brancz/urchin-plus-plus/reports/phase6/jlc-placement/dock-diodes.png

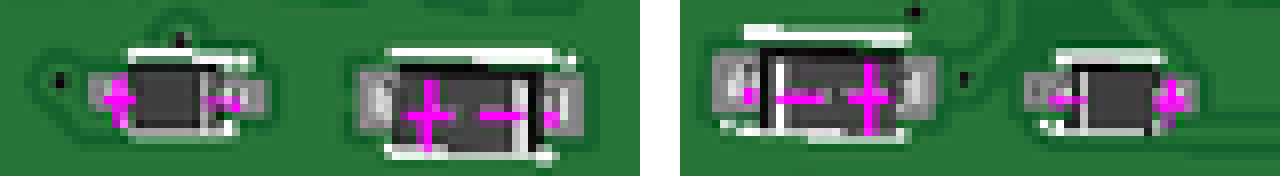
reports/phase6/jlc-placement/dock-diodes.png
