brancz/urchin-plus-plus/reports/phase3/render-left-top.png

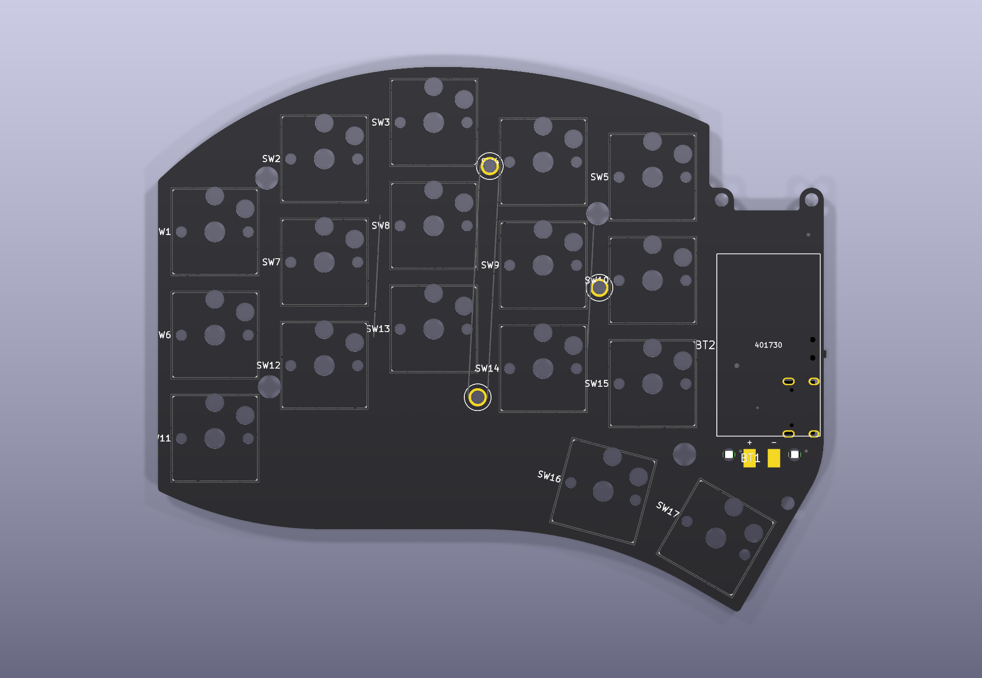
reports/phase3/render-left-top.png
