brancz/urchin-plus-plus/hardware/README.md

# hardware

atopile project for the keyboard halves (phase 2 onward): `ato.yaml`, `.ato` sources, `parts/` (generated by `scripts/parts/import_lcsc.py`), and the KiCad layouts for the left and right half under `layouts/`. Build with `scripts/ato_build.sh hardware`, never bare `ato build`.
