brancz/urchin-plus-plus/dock-pcb/README.md

# dock-pcb

atopile project for the dock board (phase 7), built by the same pipeline as `hardware/`: `scripts/ato_build.sh dock-pcb`.
