brancz/urchin-plus-plus/reports/phase0/README.md

# Phase 0 — toolchain proof

Dates: 2026-10-17 to 2026-10-18. Machine: macOS (arm64), bash 3.2. CI: GitHub Actions in the `kicad/kicad:9.0.9` image (Linux, bash 5), plus a macOS syntax job.

## Exit criteria

| Criterion (docs/PLAN.md) | Result | Evidence |
|---|---|---|
| Clean round-trip report | **KiCad 10.0.7: fails.** atopile can't rebuild a board KiCad 10 has saved. **KiCad 9.0.9** (the documented fallback): all 12 steps pass, locally and in CI | `kicad10-probe/`, `roundtrip/` |
| CI green on an empty build | green: run 39119942514 | see "CI" |
| Exact tool versions and Freerouting checksum in SETUP.md | recorded; `scripts/checks/toolchain.sh --local` passes, including the frozen dependency trees | `docs/SETUP.md`, `toolchain.env`, `constraints/`, `roundtrip/toolchain.txt` |
| Repo layout, `.gitignore`, CI skeleton | done | repo root, `.github/workflows/ci.yml` |
| Reviewer pass | two rounds; every finding fixed or dispositioned | `review.md` |

## Round-trip (`scripts/roundtrip/run.sh`, also run in CI)

The fixture (`scripts/roundtrip/fixture/`) is a two-resistor divider and a decoupling capacitor (LCSC C25744, C1525), both with bottom-side footprints as rule 2 requires, plus a mechanical M2 hole on the top. It is built in a throwaway git repo, and every build goes through `scripts/ato_build.sh`, the same wrapper the real boards use.

| Step | What it proves | Result |
|---|---|---|
| 1 build | first build through the wrapper | 4 footprints, format 20241229 |
| 2 pcbnew edit | JLC-like design rules, an outline, moves and rotations (one at 15°), B.Cu tracks, a via, a two-layer GND zone, the hole placed; saved by KiCad 9 | DRC 0 errors, 0 unconnected |
| 3 rebuild | every edit survives: `board_diff --strict` (empty semantic diff, identical canonical pcbnew serialization) | pass; DRC identical to step 2 |
| 4 idempotent | a second rebuild and `ato build --frozen` change nothing | pass |
| 5 add a part | exactly one footprint added, nothing else changes | pass, after `fix_stale_nets` put back 3 copper items that atopile left off their nets |
| 6 stable | rebuild and `--frozen` change nothing after the new part is placed | pass |
| 7 uncommitted save | net churn, then a pcbnew save without a commit (KiCad renumbers nets), then a rebuild: a free MID via stays MID | pass |
| 8 rename | net MID → MIDPOINT in the circuit: copper follows, and board_diff reports a rename | pass |
| 9 refused | a footprint atopile didn't create, a footprint flipped against its library side, and a locked footprint are each refused before atopile runs, and the board is left untouched | pass |
| 10 board history | `board_history.sh` over the repo's commits; a commit that drops a track fails unless its message allows it; merge commits are skipped | pass |
| 11 Freerouting | rip up, DSN export, Freerouting 2.5.0, SES import | DRC 0 errors, 0 unconnected |
| 12 KiKit | `kikit fab jlcpcb` | 16 Gerber/drill files |

DRC reports warnings only: `silk_overlap` and `silk_over_copper` from the easyeda2kicad footprints' own silkscreen (F5).

## KiCad 10 probe (`scripts/roundtrip/kicad10_probe.sh`)

atopile builds the fixture, and KiCad 10.0.7's pcbnew edits and saves it (format 20260206). The next `ato build` fails with `UnexpectedType in kicad.pcb.Layer field 'tenting'`, both with atopile 0.15.7 and with 0.15.9, the last CLI release. KiCad 10 writes `(tenting (front yes) (back yes))` into every board's setup, so every KiCad 10-saved board is affected.

## Findings about the toolchain

| # | Finding | Disposition |
|---|---|---|
| F1 | atopile (0.15.7 and 0.15.9) can't read any board saved by KiCad 10. | KiCad 9.0.9 per the fallback, installed side by side at `/Applications/KiCad9`. The guardrail rejects KiCad files newer than KiCad 9's formats, and every KiCad-using script checks the version first. |
| F2 | atopile's part server is gone: NXDOMAIN since about 2026-07-18 (atopile#1829). 0.15.8+ needs a login to a legacy endpoint (HTTP 401 without one), and the CLI is end-of-life (`upstream-checks.txt`). | All parts are local atomic parts from `scripts/parts/import_lcsc.py`, so builds are offline. Stay on 0.15.7, with its dependency tree frozen in `constraints/`. |
| F3 | atopile re-creates a net under a new number when fewer than 80% of its pads already carry its name, and leaves that net's tracks, vias, and zones behind: on macOS on the old, now meaningless number; on Linux on net 0. KiCad recomputes the net of copper that touches a pad on load, but free copper (stitching vias, stubs) and zones (resolved by `net_name`) end up on the wrong net or none. | `scripts/fix_stale_nets.py` matches each copper item by UUID to the pre-build snapshot. It keeps net numbers atopile kept (including in-place renames) and restores the rest by name. Steps 5, 7, and 8, on both platforms. |
| F4 | atopile deletes every footprint it didn't create. | Every footprint is an atopile part, mechanical ones too (atomic part, explicit `has_designator`, `exclude_from_bom`/`exclude_from_pos_files`). The guardrail refuses footprints that don't resolve to a library. Steps 2 and 9. |
| F5 | easyeda2kicad footprints draw silkscreen over their own pads. | Open item for phase 2: check each footprint against its datasheet land pattern. |
| F6 | atopile re-syncs every footprint from its library on each build and matches items by geometry only, so two items with the same geometry on different layers get merged (here an F.CrtYd circle became B.CrtYd). | The guardrail rejects such footprints. `board_diff --mode build` fails if an existing footprint's graphics, pads, attributes, or field placement change while its library footprint doesn't. |
| F7 | `kicad-cli fp/sym upgrade` writes files in its own KiCad version's format. | The importer refuses a `kicad-cli` that isn't the pinned version, and the guardrail checks every `.kicad_mod`/`.kicad_sym`. |
| F8 | `has_datasheet` makes `ato build` download the URL, and LCSC's is a product page. | The importer doesn't emit it. Datasheets go in `docs/datasheets/`. |
| F9 | Instance net-name traits on `ElectricPower.hv/lv` are ignored. | Open item for phase 2: name rails on plain signals. |
| F10 | KiKit's `fab jlcpcb --assembly` needs a schematic, and atopile produces none. | Open item for phase 6: BOM from atopile, CPL from `kicad-cli pcb export pos`. |
| F11 | atopile flips each footprint to its library's side and back on every build. For a front-side library footprint placed on the bottom, the flip corrupts text rotations on every build (permanent `--frozen` failure). | Bottom-side parts get bottom-side library footprints (`footprint_to_bottom.py`, the importer's default), and the guardrail refuses a footprint on the other side from its library. Steps 2–6 at 15° and 270°, plus the step 9 refusal. |
| F12 | atopile drops whatever its data model lacks: locks on footprints, tracks, and zones; zones inside footprints; `fp_curve`; text boxes; groups; extra zone outlines. | The guardrail mirrors atopile's model (`pcb.zig`) and refuses such content before building. Keep-outs, including the antenna keep-out (rule 6), are board-level rule areas. Step 9 (lock). |

## CI

Green: https://github.com/brancz/urchin-plus-plus/actions/runs/39119942514 (commit 6c2ccd6). In that run:

- toolchain check OK, and all 137 installed atopile/KiKit packages are pinned
- the 12-step round-trip passes on Linux
- the guardrails pass on the committed KiCad files
- board history is OK (no design boards yet)
- the macOS job parses every script with bash 3.2 and compiles them with Python 3.9
- the dock environment installs from its lockfile

Earlier runs failed twice, and both failures led to fixes. In the first, the round-trip failed at step 5 on Linux, which is how F3's platform difference was found. In the second, the guardrail correctly rejected the KiCad 10 evidence board under `reports/`.

The second review round's fixes were checked against the reviewer's repro scripts and are covered by the round-trip. They have not been re-reviewed independently.

## Reproduce

```bash
scripts/checks/toolchain.sh --local
scripts/roundtrip/run.sh scratch/roundtrip reports/phase0/roundtrip
scripts/roundtrip/kicad10_probe.sh /Applications/KiCad/KiCad.app reports/phase0/kicad10-probe
scripts/roundtrip/upstream_checks.sh > reports/phase0/upstream-checks.txt
```
