brancz/urchin-plus-plus/reports/phase7/review.md

# Phase 7 review: findings and dispositions

## Dock review

The reviewer subagent reviewed the dock (the dock PCB and the tray) on 2026-10-24, in the uncommitted working tree after 93ffe1b, from artifacts and datasheets only. It re-ran KiCad 9.0.9's DRC on a copy (0 errors, 0 unconnected, 11 cosmetic warnings), a zone refill (no change) and `mech dock-geometry --check` (current). It did not re-run the full `mech build`.

It confirmed, with no findings:

- J1 (C2927029): pinout A5 CC1, B5 CC2, A9/B9 VBUS, A12/B12 GND, shell GND; the pad order, leg pads and slots, leg spacing, and the front face flush with the board edge.
- Two separate 5.1 kΩ CC pull-downs; LED1 pad 1 is the anode (about 1.2 mA); D1 pad 1 is the cathode, on DOCK_5V; F1 between VBUS and DOCK_5V.
- The pogo pins' 2.3 mm lands and nets (GND / 5V / GND), on the halves' TP1 pads, and the magnet cutouts on MK2.
- The outline, holes and J1 against `geometry.json`; copper widths for 0.2 A and for a fault until the fuse trips; BOM and CPL (7 lines, all top side, stock checked); the tray pieces on the 180 mm bed; screw engagement; magnet walls and depth.

| # | Finding | Disposition |
|---|---|---|
| H1 | The rubber feet's height was unspecified, and the documented heights (3.5 mm; 5 mm with a USB cable) would lift a case off the pins: the tray's foot pockets fitted a foot of at most 2.4 mm. | **Fixed.** The tray's holes under the feet go right through (10 mm for the 6 mm feet), so any foot up to 7.4 mm tall docks (`checks.json` → `hardware`, "case feet"). The hardware list asks for 6 × 2 mm bumpers. ARCHITECTURE now says the old minimums were for the bare board: in the case, the floor covers the bottom parts, and a plugged-in cable's overmold stays about 0.3 mm above the case's underside (corrected in the second review, L-2). |
| M1 | The free pin tips (13.0 mm) stood above the rim (12.0 mm), so the walls couldn't guide a half before it met the pins. | **Fixed.** The pockets are 8.2 mm deep. Their straight walls reach 7.0 mm above the floor, above the tallest free tip in the worst case (6.46 mm) plus the case's 0.4 mm bottom chamfer, so the case is in the straight walls before its underside reaches the tips. A new check enforces it ("the pocket guides a half before the pins meet it"). The pins now stay below the rim with nothing docked. |
| M2 | The pin-landing check left out the dock PCB's float, the screws, the flange on its land, the pin's tilt and the case's rotation. | **Fixed.** `dock_checks.py` now solves how far a case moves and turns in its pocket, and a board in its case (its walls and its three locating screws), from their outlines as a linear program. To that it adds the dock PCB on its bosses (0.25 mm, with JLC's ±0.2 mm on the milled holes), pocket to boss (0.1), the flange on its land (0.15) and tilt (0.1), per axis. The bosses now locate the bar: 0.15 mm clearance round them, while the outline has 0.3 mm. The RSS is 0.86 mm against 1.1 mm of room across the pad; the worst case, 1.69 mm, is reported (it misses the pad's 1.25 mm half-width only if every term lines up). The same stack sizes the case's window: it needs 1.54 mm and has 1.75 mm, after widening its margin from 1.0 to 1.5 mm (the old 1.0 mm failed the new check). |
| M3 | The feet had 0.5 mm radial clearance in Ø7 pockets, less than the case's float plus the foot's play in its seat. | **Fixed.** The holes are 10 mm. The new check moves each foot by the case's solved play plus 0.2 mm in its seat: at most 1.4 mm, against 2.0 mm of room to the hole's wall and to the dock PCB's edge. |
| M4 | The VBUS link from A9 to B9 ran on F.Cu under J1's grounded shell, before the fuse. | **Fixed.** A rule area J1_FRONT (F.Cu, no tracks or vias) covers J1's footprint from 0.2 mm in front of its pad row to its front. `place.py` draws it and checks it, and DRC enforces it. After re-routing, VBUS joins A9 and B9 behind the pads. |
| M5 | Each tray insert had a 0.43 mm wall beside the hollow under the receptacle's legs. | **Fixed.** The screws moved from 7.0 to 8.3 mm either side of the receptacle (the tab widened to 21 mm). A new check measures the printed wall round each insert hole over its depth: 1.72 mm, against a 1.0 mm minimum. |
| L1 | 0.2 mm recess clearance is no more than JLC's ±0.2 mm outline tolerance. | **Fixed/accepted.** The outline has 0.3 mm. The magnet bosses keep 0.15 mm, because they now locate the bar (M2). Their float, holes included, is in the landing stack. If the board doesn't drop over the bosses, sand the bosses (assembly step 2 in `mech/README.md`). |
| L2 | The pin's datasheet is thin; the compression stack left out the case's standoffs (linear minimum 0.19 mm). | **Fixed.** The stack now includes the case's standoffs and the pin's solder joint, per term. By RSS the compression is 0.51 to 1.09 mm, inside 0.2 mm to the 1.4 mm stroke. The worst case, 0.19 to 1.41 mm, is reported. The ±0.15 mm height tolerance is still the 4020-01R sibling's (stated in `params.py`), so the assembly steps now include measuring the pins' height with calipers. |
| L3 | A redundant GND track passed 0.18 mm from P2's 5 V pad; a zero-length DOCK_5V track sat at P5. | **Fixed/accepted.** The zero-length track was a 0.1 µm Freerouting stub onto a pad it saw 0.1 µm off; `route.py` now drops segments shorter than 1 µm. After re-routing, the GND track joining P1 and P3 is 0.24 mm from P2's pad, above the 0.15 mm rule, under solder mask; it stays as Freerouting left it. (The first rationale given here, that GND never depends on the pour, was false; see the second review, L-1.) |
| L4 | The EasyEDA land patterns differ slightly from the datasheets (all solderable; none wrong in polarity or pinout). | **Accepted.** These are JLC's own library footprints for these parts, which it assembles routinely. |
| L5 | A tripped polyfuse (up to 125 °C) sits on PCB resting on PLA; a steel clip across the pins would hold it tripped. | **Mitigated.** The 1.2 mm hollow under the receptacle now reaches 2 mm past the fuse's centre (about 1.2 mm past its body), so the PCB doesn't touch PLA under it. The pins are now below the pockets' rims. The README says what a dark LED means (a short, fuse tripped: unplug and clear the pocket). |
| L6 | The tray joint is weak: one insert per piece, no key, and the PCB's solder joints take the bending. | **Fixed.** Gluing the split is now an assembly step: the PCB aligns the pieces, then thin CA wicks into the 0.2 mm gap. |
| L7 | Halves may be hard to lift out against two magnets each, with no finger notch. | **Fixed.** A notch in each pocket's outer wall (9 mm radius, down to 1 mm above the floor) gives a finger the case's side. Lifting force is still to be felt on a print. |

## Second review

The reviewer subagent reviewed phase 7 again on 2026-10-24, from artifacts and datasheets only: the dispositions above, the cases and battery covers (their first review), and anything the fixes might have broken. It reproduced `scripts/dock/fab.sh` (identical BOM and CPL, DRC 0 errors) and `scripts/mech/build.sh` (identical `checks.json`), re-solved the dock's play LP with only the outline segments that face a wall (same result), and probed unfilled-zone connectivity, standoff walls, thin regions and part heights with its own scripts.

It verified H1, M1–M5, L1, L2, L6 and L7 as described, and found L3's rationale false and L5's wording loose (both corrected above). No finding needs a change to the keyboard PCB.

It confirmed, with no findings: the dock's pinouts and polarities against the datasheets; that even the worst-case landing leaves over 1 mm to the next pad; the screw stacks; the insert, magnet and skin walls; nearest metal to the antenna keep-out (34.4 mm); the covers over the battery and LED windows; the USB-C notch and plug clearances; printability (bed, slicer, negligible thin regions); the dock's rule areas and trunk; Python 3.9 and bash 3.2 parsing; and CI coverage of the dock.

| # | Finding | Disposition |
|---|---|---|
| M-A | No JLC upload checklist for the dock PCB: the owner would upload without knowing what to check, and a reversed D1 (TVS) would short 5 V and trip the fuse. | **Fixed.** `README.md` has a "JLC upload checklist: dock PCB": board options (2 layers, 1.6 mm, HASL fine, single board), top-side assembly, "Confirm parts placement", and where to look in the preview for D1's cathode band, LED1's anode, J1's mouth and legs, and the pins. Also the intended DFM items (cutouts, pin-in-paste legs, clipped silkscreen) and soldering J1's legs after delivery. |
| M-B | The lips over the board's outer edge had 0.1 mm of play: their underside fell mid-layer, and a board 0.16 mm thick (JLC's ±10 %) would not fit. The fit check couldn't see it, because the PCB is a "touching" part. A 0.6 mm lip could hold only 0.0–0.2 mm of the edge with the board's play. | **Fixed.** `LIP_PLAY` 0.2 mm puts the underside on a layer boundary at 7.0 mm, 0.04 mm over a board 0.16 mm thick; `LIP_OVER` is 0.8 mm. New rows in `checks.json` → `hardware` check both lips per half: underside on a layer boundary and clear of a thick board; the tilt a board can go in at (11° nominal, 2° thick, pushed against the wall); and how far each lip stays over the edge with the board's play in its case (solved, 0.4 mm inward) and JLC's ±0.2 mm outline: 0.35 mm by RSS (minimum 0.3), 0.2 mm worst case. |
| L-1 | The L3 rationale and `route.py`'s docstring claimed GND never depends on the pour; on the dock, P4 and P6 have no GND track and the P1–P3 track joins only those two. | **Fixed.** Both texts now say the pour completes GND (on the dock, the right half's GND pins hang on the pour alone), and connectivity is counted with the zones filled, as DRC does (0 unconnected). Electrically fine: each pin's land joins the pour on both layers through thermal spokes, for about 0.1 A. The P1–P3 track stays: 0.24 mm from P2's pad, above the rule, under mask. |
| L-2 | ARCHITECTURE put the plug's axis 4.0 mm above the case's underside and its overmold 0.75 mm clear; the receptacle hangs 3.26 mm below the PCB, so the axis is about 3.6 mm and the overmold about 0.3 mm clear. | **Fixed** in ARCHITECTURE (and H1 above). The decision holds: the notch runs full height, and the feet lift the case anyway. |
| L-3 | Compression leaves out the half's bow and twist and PLA shrink, and its worst case (0.19 mm) is already at the limit. | **Accepted, with a step.** `mech/README.md` dock step 6: check each half charges in the dock, pressed and released; if not, measure the pin height and the pad depth with calipers. The knob is named: the case's `FLOOR` (one layer less adds 0.2 mm of compression), a case reprint. |
| L-4 | The case standoffs under the two holes at the antenna end have about 0.5 mm of wall where they're cut back for nearby parts. | **Accepted, documented.** They print. The nylon screws there go in finger-tight (`mech/README.md` assembly step 5, step 3 when this was written, says why). |
| L-5 | The standoff's hex size was assumed (3.2 mm across flats) but not specified; common M2 nylon standoffs are up to 4 mm. | **Fixed.** The model is now a 4 mm hex (4.62 mm across corners), and the hardware list says "at most 4 mm across flats". The fit check passes with it (nearest: the SW17/SW33 keycap, 0.32 mm). |
| L-6 | The insertion check doesn't model the lips or the tilt. | **Fixed** by the lip rows (M-B): the tilt a board can go in at is now a checked number, and changing `LIP_*` moves it. |
| L-7 | The power-switch scoop left a 0.4 mm wall beside the slot. | **Fixed.** `SWITCH_SCOOP_DEPTH` 1.2 mm leaves 0.8 mm (two lines). |
| L-8 | Nits: a params comment said M2 × 4; `fab.sh` named the wrong Gerber zip; no action given for a pin out of range; magnet pockets and foot holes look alike from below; the cover can rock by the board's thickness tolerance; the fit row didn't name the lips' exemption; L5's wording. | **Fixed:** the comment, the zip name, the pin step (reflow, or note it and see step 6), which holes take magnets (dock step 1), the fit row, L5. **Accepted:** the cover rocking by up to 0.16 mm is cosmetic. |

## Hardware change

After the phase closed, the hardware was changed to parts sold in Germany (`docs/ARCHITECTURE.md`, "Hardware bought in Germany"): posts printed on the battery cover and nylon nuts instead of bought standoffs, M5 washers instead of steel discs, and a fit model of the largest 401730 cell sold. The reviewer subagent reviewed the change on 2026-10-24 in the uncommitted working tree after 1d533fc, from artifacts and datasheets only. It re-ran `scripts/mech/build.sh` without renders (identical `checks.json`, 0 failed) and probed the cell, keycaps, LED holes, posts, screw heads, magnet force and footprints with its own scripts.

No high-severity findings, 2 medium, 8 low. None needs a change to the keyboard PCB.

It confirmed, with no findings: the screw stack (head 0.2 mm inside the underside, tip 1.8 mm above the nut, 1.45 mm at the screw's shortest), the head's bearing on the standoff, the heads against the dock parts, the posts printing roof down without overhangs, rule 6 (only nylon and PLA at the holes in the keep-out; the washers 47.3 mm away), the washer in its recess, the 6.4 mm magnet pocket, the roof over the cell (0.5 mm), the cell against the keycaps beside it (1.16 mm), the assembly order, and the fit rows lost and gained against the previous commit.

| # | Finding | Disposition |
|---|---|---|
| M1 | The cover's posts (4.6 mm round) and the nuts sat 0.33 mm from four keycaps (left SW5 and SW17, right SW18 and SW33) over the keycaps' whole height, and only the screws locate the cover: about 0.4 mm of play on a 2.4 mm bore. The checks tested only the nominal position, and `KEYCAP_MARGIN`'s comment and ARCHITECTURE's "clear the keycaps the same way" were false. | **Fixed.** Posts 4.0 mm across on a 2.3 mm bore (0.85 mm of wall, two lines; the bore prints about 2.2 mm and locates the cover on the screws). New fit rows grow each post by the cover's play (0.36 mm: the screw off the PCB hole's centre plus the bore off the screw, at an M2's smallest diameter): 0.261 mm from SW5, SW17, SW18 and SW33 (nominal 0.625). The nuts next to a keycap are turned with a flat toward it (`mech/README.md` step 6), and the nut model is that hexagon grown by its screw's play (0.16 mm): 0.467 mm. `KEYCAP_MARGIN`'s comment and ARCHITECTURE corrected. |
| M2 | The longer cell runs onto the wire pads (BT1) and partly over both LED light holes; the model placed it from the courtyard, not the outline the docs name; no check sees board parts against the cell. | **Fixed, placement kept.** The cell stays on the outline's antenna-side end: moving it toward the antenna would use up the 3 mm keep-out margin. `board_data.py` now extracts BT2's outline and BT1's pads; the model starts at the outline (3.75 mm from the keep-out), and a new hardware row reports the keep-out gap (at least 3 mm), the reach over the pads (0.4 mm), the room above the solder joints on the 1 mm foam (0.2 mm for a 28 AWG wire laid flat) and how much of each LED hole it covers (21 %, at most half allowed). `mech/README.md` ("The cell") now says to cut the foam to the outline, solder the wires first, then lay the cell. |
| L1 | The cover-screw stack no longer applied `MIN_THREAD` (the nut gives 1.6 mm). | **Fixed.** `MIN_THREAD` is now stated as the rule for screws in printed parts and inserts; a nut must have its whole height engaged (DIN 934 sizes it for the screw), and the row checks that with a board 0.16 mm thick (tip 1.64 mm above the nut). |
| L2 | The nut and the untrimmed screw end stand above the neighbouring keycaps; the README said to trim "if you like"; a nut driver doesn't fit beside the keycaps. | **Fixed.** `mech/README.md` step 7: trim all three flush with the nut. Step 5: hold the nut with tweezers, or pull the two nearest keycaps. The nut's top stays 1.2 mm above the keycap model's top, where the old M2 × 3 heads were 0.4 mm above it: accepted. |
| L3 | The washer's recess adds 0.1–0.3 mm to the magnet gap, so the hold is weaker than "70 % of a disc" (estimate: 10–12 N per half against at most about 3.5 N from the pins less the half's 1 N); dock step 6 didn't test the hold. | **Fixed.** Dock step 6 checks by hand that a half sits flat, doesn't rock and takes a definite pull to lift, and names the remedies: 10 × 5 mm magnets, then a thinner skin under them. ARCHITECTURE gives the estimate instead of the 70 % figure. |
| L4 | The skirt and the posts both rested at the PCB's top height, so with a thin board the posts don't clamp the PCB. | **Fixed.** The skirt ends one layer (0.2 mm) above the wall's top (`SKIRT_LIFT`), on a layer boundary: the posts set the cover's height. |
| L5 | Stale or inconsistent docs: standoffs in ARCHITECTURE, the cell's size in three versions, the cell from the courtyard vs the outline, "steel disc" in several places, the phase 6 checklist's two nylon screws. | **Fixed** in ARCHITECTURE, `params.py`, `mech/README.md` and `reports/phase6/README.md`: the cell is "up to 32 × 17.5 mm and 4.5 mm thick" everywhere, modelled from the outline; three nylon screws and nuts per half. |
| L6 | `docs/SETUP.md`: female-female jumpers can't connect to TP2's surface-mount pads. | **Fixed.** SETUP and `firmware/README.md`: solder a 5-pin 2.54 mm header or five wires to TP2 for the first flash and remove it before casing, or use a 2.54 mm pogo clip. |
| L7 | The README's status cites a CI run older than these rows; no review entry for the change. | **Fixed.** This section, and the README's status separates the phase's CI run from this change's. |
| L8 | No lead-in on the post's bore for a screw fed blind from below; a DIN 985 lock nut (steel body) is a likely mis-buy in the keep-out. | **Fixed.** A 0.3 mm chamfer at the bore's bottom; the hardware list says all-polyamide DIN 934, not DIN 985. |

## Top shell and dock redesign

The reviewer subagent reviewed the top shell (commit 6435626) and the dock redesign (uncommitted, on top of it) on 2026-10-25, from artifacts and datasheets only: the board files, the STEP export, the Gerbers and CPL, the datasheets of C2848622, C5221284, C123790, C2297 and the Choc v1 switch, and its own computations. It didn't rely on the reports' claims.

One high-severity finding, 5 medium, 7 low. **None needs a change to the keyboard PCB that is already ordered:** the pins solder onto the existing TP1 pads (2.5 × 4.0 mm, for the 2.0 mm flange; the GND pads have thermal reliefs, so they can be hand-soldered). The fixes touch the dock PCB, which is not ordered, and printed parts.

It checked, with no findings: the dock's netlist and polarity (J1's VBUS, GND, CC1 and CC2 each through its own 5.1 kΩ; F1 from VBUS to DOCK_5V; D1's cathode on DOCK_5V; LED1's anode toward R3; the contacts GND / 5 V / GND in TP1's order), the BOM against `dock-bom.md`, the CPL against the Gerbers, DRC and connectivity, ENIG in the board file, and the slots in the PTH drill file.

The CI run of commit 6435626 (40194850673) failed in `scripts/mech/build.sh` on Linux: OCCT could not chamfer the shell's outer walls (`ValueError: Failed creating a chamfer`, `case.py` `shell()`), though it builds on macOS. The case chamfers the same outline by the same 0.6 mm, built at z = 0, and that passes on Linux. **Fixed:** the shell's walls and lid are now chamfered at z = 0 and then moved up, as the case is. This commit's CI run is the proof on Linux; the phase's README records it.

| # | Finding | Disposition |
|---|---|---|
| H1 | The soldering jig covered the pads: none of each TP1 pad beyond the flange was in view from above. The 3 mm strip over the pin row and the bars to the legs and feet lay over the pads' ends, 4.6 mm above the board, so README step 4 ("touch the iron to each pad … at its ends") could only be done sideways past D2, D3 and the barrels, with the PLA plate in the way. `jig_checks` didn't model the iron's access. | **Fixed.** The plate is now a 0.8 mm collar round each bore joined by a 1.8 mm strip along the row, inside the 2.0 mm flanges; the arms to the legs and feet start from the strip's ends, 4.5 mm past the end pins. New rows (`hardware`, per pad and end, both halves): 1.24 mm² of each pad's end (3.43 mm² past the flange) is in view past the plate grown by 0.25 mm, where at least 1.0 mm² is required; before, none was. `mech/README.md` step 4: come in at an angle, keep each touch to 2 to 3 s, keep the iron off the jig. |
| M1 | The bores had 0.1 mm of clearance on the 0.9 mm plunger, a printed hole comes out about 0.1 mm small, and the tips came out through the plate's first layer, with its elephant's foot. | **Fixed.** Bores 1.25 mm (0.35 mm over the plunger). The plate is 2.0 mm thick, so the tips end inside it: 0.55 mm short of the face printed on the bed, 0.3 mm with the longest pin (new terms in the row "jig plate on the plungers"). README step 3: open a tight bore with a 1.2 mm drill by hand. The pin's position error in the jig grows from 0.2 to 0.3 mm in the landing and window stacks: landing 0.91 mm by RSS across a contact (1.45 mm of room) and 0.90 mm along it (2.85 mm); the window needs 1.1 to 1.2 mm and has 1.98 mm. |
| M2 | J1's 3D model sat 0.28 mm off its footprint: its legs 0.28 mm from the slots' centres, into the board. The real part, its legs in the slots, would stand 0.28 mm out of the tray's back face, and its housing would overlap the PCB at the notch's end. The mouth check passed only because it measured the misplaced model, and no row tested J1 against the board. | **Fixed.** Confirmed from HRO's drawing and the model: the mouth is 2.80 mm ahead of the front legs (the 6.8 mm body less 4.00 mm from the front legs to its back). The model's offset in `dock-pcb/parts.json` is now -1.88 mm, which puts its legs on the slots; the footprint's origin moves to 5.28 mm from the back face (`DOCK_USB_FRONT`), so the real mouth is on the face (row "USB-C mouth on the tray's back face"). New fit row: J1's model against the dock PCB, no overlap (it rests on the board's top; its housing is 0.10 mm from the notch's end). J1, R1 and R2 moved 0.28 mm in, and the board was re-placed and re-routed (below). |
| M3 | The notch had sharp inner corners and about 0.08 mm at its end; HRO's layout ends the notch 0.5 mm behind the rear legs, and JLC's router leaves a radius in an inside corner. | **Fixed.** The notch ends 0.5 mm behind the rear legs, as HRO's layout has it (1.62 mm behind the footprint's origin, 0.10 mm behind the housing), and has a 1.0 mm round relief behind each inner corner, so JLC's 1.0 mm router reaches the corners. Reliefs to the side would cut into the legs' pads. The model shows that the part below the board at the notch's end is the plastic housing, 8.34 mm wide, so its corners are 0.43 mm from the notch's sides anyway. With the deeper notch, the signal pads are trimmed 0.14 mm instead of 0.12 (1.26 mm long), for 0.3 mm copper-to-edge. |
| M4 | No minimum foot height was given (README: "about 2 mm"), and the desk check used 2.0 mm feet, uncompressed: 0.35 mm to spare at worst, and a soft desk mat or a squashed bumper puts the pins on the desk. | **Fixed.** The hardware list asks for feet 2.5 to 3 mm tall ("at least 2.5 mm"). The desk row now uses the shortest allowed foot, less its seat and 0.2 mm of squash (`FOOT_SQUASH`): the feet hold the case 1.9 mm up, the tips reach at most 1.25 mm below it: 0.65 mm to spare at worst (0.35 mm before, on nominal 2 mm feet). |
| M5 | The pins have no lateral support: a sideways knock on a 0.85 mm tip acts on a 6 mm lever at a hand-soldered joint on the ordered board's TP1 pads. Proposed: per-pin bores in the floor, about 0.4 mm over the plunger. | **Not adopted.** The pin moves with the board, so a bore must take the board's play in its case and the pin's own error: 1.0 to 1.1 mm a side (the window rows). The barrel's end is inside the 1.6 mm floor, so bores round the barrels would be about 3.8 mm at the 4 mm pitch, and a 0.4 mm bore would bend the pins as the board goes in. The tips are recessed: they stand 0.85 mm below the case's underside, inside the window, and the feet stand 1.9 mm or more, so nothing on a desk reaches them sideways. A pin that bends is resoldered, and TP1's pads are 2.5 × 4.0 mm. |
| L1 | J1's land pattern differs from HRO's: pad front edges further back, a shorter overlap with the tails, slots 0.8 mm wide instead of 0.5. | **Accepted.** The board is power only, and the four through-hole legs (pin-in-paste, and hand-soldered per the checklist) carry the cable's load. |
| L2 | The compression check passes on RSS only; at the RSS minimum, 0.55 mm, the pin is under the 1.0 mm working height at which the datasheet gives its force. | **Accepted.** `mech/README.md` dock step 6 tells the builder how to check and adjust (`FLOOR`). |
| L3 | The worst-case landing goes past the contact's edge; it can't short (the tip would need 1.95 mm to reach the next pad). | **Accepted.** With the jig's 0.3 mm (M1), the worst case is 1.89 mm across, still short of 1.95 mm: an open contact at worst, never 5 V to GND. |
| L4 | Only the tab is held down (under the cover); a bar bowed up by JLC's 0.75 % adds to the compression. | **Fixed.** Dock step 2: a small drop of CA under each bar's outer end, pressed flat for a minute. |
| L5 | Keycaps near the battery lid: 0.36 mm nominal, 0.26 mm with the shell's play. | **Accepted.** The plate locates the shell on the switches (14.0 mm cutouts on the 13.8 mm housings), so the play figure is pessimistic. |
| L6 | The board's stackup says a black solder mask, the checklist said green. | **Fixed.** The checklist says black, as the board does: the board shows in the pocket floors, and black disappears in a black tray. Any colour works. |
| L7 | Not modelled: the M5 washer's hole reduces the magnets' pull (dock step 6 checks it by hand); the plate's 0.55 mm overhang over the clip relief droops a little; black carbon-pigmented PLA over the antenna detunes it slightly (allowed by rule 6). | **Noted.** |

The reviewer also flagged the checks' blind spots, each covered above: the mouth check (M2), iron access and bore shrinkage (H1, M1), the desk with nominal feet (M4), compression and landing on RSS (L2, L3), and the router's corner radius (M3).

The dock PCB after these fixes: J1 0.28 mm further in, with the deeper notch and its reliefs; R1 and R2 moved with it, to keep their place below J1's CC pads. J1's two VBUS tracks join below R1 and R2 at the fuse, on the top layer, which boxed their GND pads in: the router left one connected by a single thermal spoke, and after the move not at all. A scripted pre-route now joins their GND pads through a via between them to the bottom pour (`scripts/routing/preroutes.py`). Re-routed with `route.py --attempts 4`: every variant complete, no starved thermals; 28 tracks, 94 vias, DRC 0 errors, 0 unconnected, 13 warnings (silkscreen at the edge and on pads, as before; J1's outline now also meets the reliefs).

## Floor plates

The reviewer subagent reviewed the floor plates, the 1.2 mm case floor and the 3 mm feet (uncommitted, on top of commit 06f3b06) on 2026-10-25, from artifacts and datasheets only: the diff, the docs, `checks.json`, `slice.json`, the renders, the datasheets of C5221284 and C48783831, its own rebuild of the checks (byte-identical to `checks.json`) and its own measurements of the STEP files.

No high-severity finding, 1 medium, 8 low. **None touches the keyboard PCB or the dock PCB.**

It checked, with no findings: the pins' dimensions and stroke against both datasheets; the height stack (5.15 mm pins, 0.85 mm compression, free tips 1.25 mm below the case, feet 2.4 mm with 0.75 mm to spare, guidance); the docked pin model; the plate's play solved from its outer outline; the slot (12.0 × 6.8 mm, the contacts' corners inside its rounded corners); the 11 mm foot holes; the plates' fit; the washer pads clear of every bottom part; 0.8 mm of standoff round each screw head's counterbore below the floor; the magnet gap (0.9 to 1.15 mm); and every number in the docs against `checks.json` and `slice.json`, with the exceptions below.

| # | Finding | Disposition |
|---|---|---|
| M1 | Dock step 7 named the plate's thickness (`DOCK_FLOOR_T`) as the quickest compression knob, "reprint only the plates". But the tray's top follows it, so the rebuild changes the tray and the cover too, and fails the guidance check, while the parts actually built (the old tray with a thinner plate) are never modelled. A one-layer plate is also fragile. Step 7 also no longer named a remedy for a weak magnet hold. | **Fixed.** The plate is no longer offered as a knob: the case's floor (`FLOOR`) stays the knob for compression, a case reprint, as before. Step 7 now says what a weak hold needs: a CAD change, a hole in each plate over each magnet (0.4 mm closer). |
| L1 | Over the pilot hole beside the thumb keys (H5), the shell's deck went from 1.0 to 0.6 mm, with no check; and the screw's length tolerance (ISO 4759-1 grade A, about ±0.29 mm at 8 mm) wasn't in the tip-gap check: 0.15 mm with a long screw and a thin board, under `MIN_TIP_GAP`. | **Fixed (checked), accepted (values).** New rows check the shell over each pilot's end against `PILOT_MIN_ROOF`, 0.6 mm (three layers, the cover's own minimum skin): 0.6 mm at H5, 3.2 mm under the lid. The screw row now reports the tip gap with a long screw on a thin board (0.15 mm) and fails if it reaches zero. M2 × 8 stays: an M2 × 6 would leave 1.24 mm of thread, under the 2.0 mm minimum, and the head can't go lower. The tip never reaches the pilot's end, so the roof takes no load from it. |
| L2 | Stale numbers in the phase README: the cover is 1.12 mm over J1, not 0.72, and the opening round J1's mouth no longer cuts into the back face's chamfer; a code comment still said it did; "the tip 0.44 mm above the pilot's end" means short of it. | **Fixed**, all three, and the comment in `dock_checks.py`. |
| L3 | The phase README's status line cited this section before it existed. | **Fixed** by this section. |
| L4 | "It drops in only one way" was false: the plates are mirror images within 0.25 mm, so one turned over fits the other pocket, ironed face down. | **Fixed.** Dock step 5 says to lay each plate smooth (ironed) face up, and why. |
| L5 | Spot-gluing a thin ironed plate "near the walls" is ambiguous along the inner wall, where the PCB runs; CA blooms white on black PLA; glue under the plate isn't in the height stack. | **Fixed (instructions), accepted (stack).** Step 5 names where: on the bare tray floor about 3 mm in from the outer, front and back walls, never on the PCB (along the inner wall and under the contacts), never near the slot or holes; gel CA, as little as holds, the pocket open to air while it sets. Glue can only lift a plate, which lowers compression; step 7 checks compression on the built dock. |
| L6 | The compression worst case (1.56 mm) was reported past the 1.4 mm stroke without saying so; the dock PCB's thickness and the recess's depth can only take the contacts deeper (where the PCB stands proud, the plate and the case rest on it), so the real high side is 1.30 mm. | **Fixed.** Those two terms now count only toward the least compression (`DOCK_DEPTH_TOL`). The row reports 0.54 to 1.09 mm by RSS, worst case 0.14 to 1.30 mm, and now fails if the high worst case passes the stroke. Guidance uses the same high side: the tips meet the contacts at 1.30 mm at worst, under the 1.6 mm of straight wall. |
| L7 | Weak spots in the checks: the case's floor openings were cut only through the floor, while the washer pads reach 1.6 mm (each pad 0.3 mm from the dock window); the plate's thin-strip check would pass a short 0.5 mm neck; the slot check had no worst-case flag; the plate's play ignored the cover's own play where the cover forms a pocket wall. | **Fixed.** The floor openings now go through the pads' height. The thin-strip check now allows 0.05 mm² of loss, not 0.5. Each pin row reports whether the worst case stays in the slot (across, about 1.9 mm against 1.55 mm: only if every term lines up, as on the contact). The cover is cut back by its own clearance at the plate's height round each pocket, so a plate keeps its 0.15 mm wherever the cover sits. Above the plate, the cover's wall can still stand 0.15 mm into a pocket, where a plate just goes in under it. |
| L8 | The feet row said shorter feet than 3 mm let the pins touch the desk; 2.5 mm feet still clear it by 0.25 mm at worst, and the owner may already have them. | **Fixed.** The hardware list asks for 3 mm and says 2.5 mm feet still clear the desk by 0.25 mm at worst. |

After the fixes: 161 fit, 11 bed, 86 hardware, 4 insertion and 15 pin checks, 0 failed.
