brancz/urchin-plus-plus/reports/phase4/drc-left.md

# DRC: hardware/layouts/left/left.kicad_pcb (left)

Errors: 0. Unconnected items: 0.

Excused errors (hardware/drc_allow.json):

- 5 x inherited from the original: the tenting puck's bottom courtyard overlaps key socket courtyards (rule 1 geometry; ARCHITECTURE.md 2026-10-18)
- 2 x inherited from the original: hotswap socket pads of SW5/SW17 (left) and SW22/SW27/SW32 (right) overhang the outline by up to 0.4 mm (rule 1; the router trims them)

Warnings by type:

- connection_width: 1
- missing_courtyard: 7
- silk_edge_clearance: 5
- silk_over_copper: 72
- silk_overlap: 50
- starved_thermal: 1
