brancz/urchin-plus-plus/reports/phase6/drc.md

# DRC: /Users/brancz/src/github.com/brancz/urchin++-p4/fab/panel/panel.kicad_pcb (panel)

Errors: 0. Unconnected items: 0.

Excused errors (hardware/drc_allow.json):

- 9 x inherited from the original: the tenting puck's bottom courtyard overlaps key socket courtyards (rule 1 geometry; ARCHITECTURE.md 2026-10-18)
- 5 x inherited from the original: hotswap socket pads of SW5/SW17 (left) and SW22/SW27/SW32 (right) overhang the outline by up to 0.4 mm (rule 1; the router trims them)

Warnings by type:

- connection_width: 14
- missing_courtyard: 97
- silk_edge_clearance: 10
- silk_over_copper: 143
- silk_overlap: 117
- starved_thermal: 1
