brancz/urchin-plus-plus/reports/phase3/drc-left.md

# DRC: hardware/layouts/left/left.kicad_pcb (left)

Errors: 0. Unconnected items: 123 (not routed yet; not counted).

Excused errors (hardware/drc_allow.json):

- 5 x inherited from the original: the tenting puck's bottom courtyard overlaps key socket courtyards (rule 1 geometry; ARCHITECTURE.md 2026-10-18)
- 2 x inherited from the original: hotswap socket pads overhang the outline by up to 0.4 mm (rule 1; the router trims them)

Warnings by type:

- missing_courtyard: 7
- nonmirrored_text_on_back_layer: 37
- silk_edge_clearance: 5
- silk_over_copper: 83
- silk_overlap: 116
