brancz/urchin-plus-plus/reports/phase2/pinmap.md

# Pin map

Generated by `scripts/circuit/gen_halves.py` (`hardware/pinmap.json`). Keys are named rRcC (row 0 = top, column 0 = pinky) and t0/t1 (thumbs, t0 nearer the main keys). GPIO pad: the socket pad wired to the GPIO; the other socket pad is ground. Path: shortest route length from the module pad around the module, the cost the assignment minimizes.

## Left half

| Signal | Switch | GPIO | E73 pin | GPIO pad | Path (mm) |
|---|---|---|---|---|---|
| r0c0 | SW1 | P0.20 | 32 | 2 | 78.7 |
| r0c1 | SW2 | P0.24 | 35 | 2 | 61.6 |
| r0c2 | SW3 | P1.02 | 38 | 2 | 49.5 |
| r0c3 | SW4 | P1.04 | 40 | 2 | 30.4 |
| r0c4 | SW5 | P1.06 | 42 | 2 | 17.3 |
| r1c0 | SW6 | P0.07 | 22 | 2 | 82.8 |
| r1c1 | SW7 | P0.17 | 30 | 2 | 60.4 |
| r1c2 | SW8 | P0.22 | 34 | 2 | 43.4 |
| r1c3 | SW9 | P0.13 | 33 | 2 | 22.4 |
| r1c4 | SW10 | P1.00 | 36 | 2 | 6.0 |
| r2c0 | SW11 | P1.09 | 17 | 2 | 85.2 |
| r2c1 | SW12 | P0.12 | 20 | 2 | 66.2 |
| r2c2 | SW13 | P0.15 | 28 | 2 | 41.9 |
| r2c3 | SW14 | P0.04 | 18 | 2 | 31.5 |
| r2c4 | SW15 | P0.08 | 16 | 2 | 16.0 |
| t0 | SW16 | P0.05 | 15 | 2 | 33.3 |
| t1 | SW17 | P0.31 | 9 | 1 | 38.0 |
| chg_sense | (near D4) | P0.06 | 14 | - | 19.7 |
| led_b | (near R10) | P0.30 | 10 | - | 25.4 |
| led_g | (near R9) | P0.00 | 11 | - | 22.6 |
| led_r | (near R8) | P0.01 | 13 | - | 22.7 |
| pgood_sense | (near D5) | P0.26 | 12 | - | 22.2 |

## Right half

| Signal | Switch | GPIO | E73 pin | GPIO pad | Path (mm) |
|---|---|---|---|---|---|
| r0c0 | SW22 | P0.31 | 9 | 1 | 82.5 |
| r0c1 | SW21 | P1.13 | 6 | 1 | 67.6 |
| r0c2 | SW20 | P0.03 | 3 | 1 | 52.4 |
| r0c3 | SW19 | P1.10 | 2 | 1 | 33.2 |
| r0c4 | SW18 | P1.11 | 1 | 1 | 18.4 |
| r1c0 | SW27 | P0.00 | 11 | 1 | 83.9 |
| r1c1 | SW26 | P0.30 | 10 | 1 | 68.5 |
| r1c2 | SW25 | P0.02 | 7 | 1 | 47.3 |
| r1c3 | SW24 | P0.29 | 8 | 1 | 28.6 |
| r1c4 | SW23 | P0.28 | 4 | 1 | 9.1 |
| r2c0 | SW32 | P0.05 | 15 | 1 | 87.3 |
| r2c1 | SW31 | P0.01 | 13 | 1 | 67.1 |
| r2c2 | SW30 | P0.26 | 12 | 1 | 50.9 |
| r2c3 | SW29 | P0.06 | 14 | 1 | 33.8 |
| r2c4 | SW28 | P0.08 | 16 | 1 | 17.5 |
| t0 | SW34 | P1.09 | 17 | 1 | 31.8 |
| t1 | SW33 | P0.04 | 18 | 2 | 33.7 |
| chg_sense | (near D4) | P0.12 | 20 | - | 19.1 |
| led_b | (near R10) | P0.24 | 35 | - | 33.2 |
| led_g | (near R9) | P0.15 | 28 | - | 31.8 |
| led_r | (near R8) | P0.07 | 22 | - | 24.5 |
| pgood_sense | (near D5) | P0.13 | 33 | - | 30.8 |
