brancz/urchin-plus-plus/reports/phase7/dock/drc.md

# DRC: dock-pcb/layouts/dock/dock.kicad_pcb (dock)

Errors: 0. Unconnected items: 0.

Excused errors (hardware/drc_allow.json):

Warnings by type:

- silk_edge_clearance: 8
- silk_over_copper: 5
