brancz/urchin-plus-plus/reports/phase2/footprints/footprints.md

# Footprints

Every assembled part's footprint as used on the boards (`hardware/parts/`), shown as the front-side land pattern (component side, top view) for comparison with each datasheet's recommended land pattern. Coordinates in mm relative to the footprint origin; rotation in degrees. The boards use the bottom-side versions (x mirrored). SVGs show the copper of each footprint.

## C356849 — WIRELM-SMD_E73-2G4M08S1C

nRF52840 module (Ebyte E73-2G4M08S1C).
Datasheet: [C356849_E73-2G4M08S1C.pdf](../../docs/datasheets/C356849_E73-2G4M08S1C.pdf).

| Pad | Type | Shape | x | y | Rot | Width | Height | Drill |
|---|---|---|---|---|---|---|---|---|
| 1 | smd | rect | -6.500 | -7.010 | 90 | 0.900 | 2.000 |  |
| 2 | smd | rect | -6.500 | -5.740 | 90 | 0.900 | 2.000 |  |
| 3 | smd | rect | -6.500 | -4.500 | 90 | 0.900 | 2.000 |  |
| 4 | smd | rect | -6.500 | -3.200 | 90 | 0.900 | 2.000 |  |
| 5 | smd | rect | -6.500 | -1.930 | 90 | 0.900 | 2.000 |  |
| 6 | smd | rect | -6.500 | -0.660 | 90 | 0.900 | 2.000 |  |
| 7 | smd | rect | -6.500 | 0.610 | 90 | 0.900 | 2.000 |  |
| 8 | smd | rect | -6.500 | 1.880 | 90 | 0.900 | 2.000 |  |
| 9 | smd | rect | -6.500 | 3.150 | 90 | 0.900 | 2.000 |  |
| 10 | smd | rect | -6.500 | 4.420 | 90 | 0.900 | 2.000 |  |
| 11 | smd | rect | -4.450 | 7.010 | 0 | 0.900 | 2.000 |  |
| 12 | smd | rect | -3.810 | 4.910 | 0 | 0.900 | 0.900 |  |
| 13 | smd | rect | -3.180 | 7.010 | 0 | 0.900 | 2.000 |  |
| 14 | smd | rect | -2.540 | 4.910 | 0 | 0.900 | 0.900 |  |
| 15 | smd | rect | -1.910 | 7.010 | 0 | 0.900 | 2.000 |  |
| 16 | smd | rect | -1.270 | 4.910 | 0 | 0.900 | 0.900 |  |
| 17 | smd | rect | -0.640 | 7.010 | 0 | 0.900 | 2.000 |  |
| 18 | smd | rect | -0.000 | 4.910 | 0 | 0.900 | 0.900 |  |
| 19 | smd | rect | 0.630 | 7.010 | 0 | 0.900 | 2.000 |  |
| 20 | smd | rect | 1.270 | 4.910 | 0 | 0.900 | 0.900 |  |
| 21 | smd | rect | 1.900 | 7.010 | 0 | 0.900 | 2.000 |  |
| 22 | smd | rect | 2.540 | 4.910 | 0 | 0.900 | 0.900 |  |
| 23 | smd | rect | 3.170 | 7.010 | 0 | 0.900 | 2.000 |  |
| 24 | smd | rect | 3.810 | 4.910 | 0 | 0.900 | 0.900 |  |
| 25 | smd | rect | 4.440 | 7.010 | 0 | 0.900 | 2.000 |  |
| 26 | smd | rect | 6.500 | 4.420 | 270 | 0.900 | 2.000 |  |
| 27 | smd | rect | 6.500 | 3.150 | 270 | 0.900 | 2.000 |  |
| 28 | smd | rect | 4.410 | 2.510 | 270 | 0.900 | 0.900 |  |
| 29 | smd | rect | 6.500 | 1.880 | 270 | 0.900 | 2.000 |  |
| 30 | smd | rect | 4.410 | 1.240 | 270 | 0.900 | 0.900 |  |
| 31 | smd | rect | 6.500 | 0.610 | 270 | 0.900 | 2.000 |  |
| 32 | smd | rect | 4.410 | -0.030 | 270 | 0.900 | 0.900 |  |
| 33 | smd | rect | 6.500 | -0.660 | 270 | 0.900 | 2.000 |  |
| 34 | smd | rect | 4.410 | -1.300 | 270 | 0.900 | 0.900 |  |
| 35 | smd | rect | 6.500 | -1.930 | 270 | 0.900 | 2.000 |  |
| 36 | smd | rect | 4.410 | -2.570 | 270 | 0.900 | 0.900 |  |
| 37 | smd | rect | 6.500 | -3.200 | 270 | 0.900 | 2.000 |  |
| 38 | smd | rect | 4.410 | -3.840 | 270 | 0.900 | 0.900 |  |
| 39 | smd | rect | 6.500 | -4.470 | 270 | 0.900 | 2.000 |  |
| 40 | smd | rect | 4.410 | -5.110 | 270 | 0.900 | 0.900 |  |
| 41 | smd | rect | 6.500 | -5.740 | 270 | 0.900 | 2.000 |  |
| 42 | smd | rect | 4.400 | -6.380 | 270 | 0.900 | 0.900 |  |
| 43 | smd | rect | 6.500 | -7.010 | 270 | 0.900 | 2.000 |  |

C356849

## C15220 — QFN-16_L3.0-W3.0-P0.50-TL-EP1.7

Li-ion charger with power path (TI BQ24073RGTR).
Datasheet: [C15220_BQ24073RGTR.pdf](../../docs/datasheets/C15220_BQ24073RGTR.pdf).

| Pad | Type | Shape | x | y | Rot | Width | Height | Drill |
|---|---|---|---|---|---|---|---|---|
| 1 | smd | oval | 1.500 | 0.750 | 0 | 0.850 | 0.280 |  |
| 2 | smd | oval | 1.500 | 0.250 | 0 | 0.850 | 0.280 |  |
| 3 | smd | oval | 1.500 | -0.250 | 0 | 0.850 | 0.280 |  |
| 4 | smd | oval | 1.500 | -0.750 | 0 | 0.850 | 0.280 |  |
| 5 | smd | oval | 0.750 | -1.500 | 0 | 0.280 | 0.850 |  |
| 6 | smd | oval | 0.250 | -1.500 | 0 | 0.280 | 0.850 |  |
| 7 | smd | oval | -0.250 | -1.500 | 0 | 0.280 | 0.850 |  |
| 8 | smd | oval | -0.750 | -1.500 | 0 | 0.280 | 0.850 |  |
| 9 | smd | oval | -1.500 | -0.750 | 0 | 0.850 | 0.280 |  |
| 10 | smd | oval | -1.500 | -0.250 | 0 | 0.850 | 0.280 |  |
| 11 | smd | oval | -1.500 | 0.250 | 0 | 0.850 | 0.280 |  |
| 12 | smd | oval | -1.500 | 0.750 | 0 | 0.850 | 0.280 |  |
| 13 | smd | oval | -0.750 | 1.500 | 0 | 0.280 | 0.850 |  |
| 14 | smd | oval | -0.250 | 1.500 | 0 | 0.280 | 0.850 |  |
| 15 | smd | oval | 0.250 | 1.500 | 0 | 0.280 | 0.850 |  |
| 16 | smd | oval | 0.750 | 1.500 | 0 | 0.280 | 0.850 |  |
| 17 | smd | custom | -0.000 | 0.000 | 0 | 0.005 | 0.005 |  |

C15220

## C165948 — USB-C_SMD-TYPE-C-31-M-12_1

USB-C receptacle, USB 2.0 (HRO TYPE-C-31-M-12).
Datasheet: [C165948_TYPE-C-31-M-12.pdf](../../docs/datasheets/C165948_TYPE-C-31-M-12.pdf).

| Pad | Type | Shape | x | y | Rot | Width | Height | Drill |
|---|---|---|---|---|---|---|---|---|
| (hole) | thru_hole | circle | 2.900 | 1.210 | 0 | 0.600 | 0.600 | 0.6 |
| (hole) | thru_hole | circle | -2.900 | 1.210 | 0 | 0.600 | 0.600 | 0.6 |
| 1 | thru_hole | oval | -4.330 | 1.710 | 0 | 1.200 | 2.000 | oval 0.799998 1.499997 |
| 2 | thru_hole | oval | -4.330 | -2.470 | 0 | 1.200 | 1.800 | oval 0.799998 1.199998 |
| 3 | thru_hole | oval | 4.330 | -2.470 | 0 | 1.200 | 1.800 | oval 0.799998 1.199998 |
| 4 | thru_hole | oval | 4.330 | 1.710 | 0 | 1.200 | 2.000 | oval 0.799998 1.499997 |
| A1B12 | smd | custom | 3.200 | 2.470 | 0 | 0.005 | 0.005 |  |
| A4B9 | smd | custom | 2.400 | 2.470 | 0 | 0.005 | 0.005 |  |
| A5 | smd | rect | 1.250 | 2.470 | 0 | 0.300 | 1.300 |  |
| A6 | smd | rect | 0.250 | 2.470 | 0 | 0.300 | 1.300 |  |
| A7 | smd | rect | -0.250 | 2.470 | 0 | 0.300 | 1.300 |  |
| A8 | smd | rect | -1.250 | 2.470 | 0 | 0.300 | 1.300 |  |
| B1A12 | smd | custom | -3.200 | 2.470 | 0 | 0.005 | 0.005 |  |
| B4A9 | smd | custom | -2.400 | 2.470 | 0 | 0.005 | 0.005 |  |
| B5 | smd | rect | -1.750 | 2.470 | 0 | 0.300 | 1.300 |  |
| B6 | smd | rect | -0.750 | 2.470 | 0 | 0.300 | 1.300 |  |
| B7 | smd | rect | 0.750 | 2.470 | 0 | 0.300 | 1.300 |  |
| B8 | smd | rect | 1.750 | 2.470 | 0 | 0.300 | 1.300 |  |

C165948

## C7519 — SOT-23-6_L2.9-W1.6-P0.95-LS2.8-BL

USB D+/D- and VBUS ESD protection (ST USBLC6-2SC6).
Datasheet: [C7519_USBLC6-2SC6.pdf](../../docs/datasheets/C7519_USBLC6-2SC6.pdf).

| Pad | Type | Shape | x | y | Rot | Width | Height | Drill |
|---|---|---|---|---|---|---|---|---|
| 1 | smd | rect | 0.950 | -1.150 | 0 | 0.532 | 1.072 |  |
| 2 | smd | rect | -0.000 | -1.150 | 0 | 0.532 | 1.072 |  |
| 3 | smd | rect | -0.950 | -1.150 | 0 | 0.532 | 1.072 |  |
| 4 | smd | rect | -0.950 | 1.150 | 0 | 0.532 | 1.072 |  |
| 5 | smd | rect | -0.000 | 1.150 | 0 | 0.532 | 1.072 |  |
| 6 | smd | rect | 0.950 | 1.150 | 0 | 0.532 | 1.072 |  |

C7519

## C8598 — SOD-123_L2.7-W1.6-LS3.7-RD-1

Schottky diodes: USB VBUS and dock 5V into the charger input (B5819W).
Datasheet: [C8598_B5819W.pdf](../../docs/datasheets/C8598_B5819W.pdf).

| Pad | Type | Shape | x | y | Rot | Width | Height | Drill |
|---|---|---|---|---|---|---|---|---|
| 1 | smd | rect | 1.700 | 0.000 | 0 | 1.200 | 0.950 |  |
| 2 | smd | rect | -1.700 | 0.000 | 0 | 1.200 | 0.950 |  |

C8598

## C193402 — SOD-123FL_L2.7-W1.8-LS3.8-RD

TVS on the exposed dock 5V pad (SMF5.0A).
Datasheet: [C193402_SMF5.0A.pdf](../../docs/datasheets/C193402_SMF5.0A.pdf).

| Pad | Type | Shape | x | y | Rot | Width | Height | Drill |
|---|---|---|---|---|---|---|---|---|
| 1 | smd | rect | 1.630 | 0.000 | 0 | 1.200 | 1.200 |  |
| 2 | smd | rect | -1.630 | 0.000 | 0 | 1.200 | 1.200 |  |

C193402

## C431540 — SW-TH_MSK12C02

power slide switch between charger OUT and VDDH (MSK12C02).
Datasheet: [C431540_MSK12C02.pdf](../../docs/datasheets/C431540_MSK12C02.pdf).

| Pad | Type | Shape | x | y | Rot | Width | Height | Drill |
|---|---|---|---|---|---|---|---|---|
| (hole) | thru_hole | circle | 1.500 | -0.550 | 0 | 0.900 | 0.900 | 0.9 |
| (hole) | thru_hole | circle | -1.500 | -0.550 | 0 | 0.900 | 0.900 | 0.9 |
| 1 | smd | rect | 2.250 | 1.700 | 90 | 1.524 | 0.600 |  |
| 2 | smd | rect | -0.750 | 1.700 | 90 | 1.524 | 0.600 |  |
| 3 | smd | rect | -2.250 | 1.700 | 90 | 1.524 | 0.600 |  |
| 4 | smd | rect | 3.600 | -1.700 | 0 | 1.200 | 0.700 |  |
| 4 | smd | rect | 3.600 | 0.600 | 0 | 1.200 | 0.700 |  |
| 4 | smd | rect | -3.600 | -1.700 | 0 | 1.200 | 0.700 |  |
| 4 | smd | rect | -3.600 | 0.600 | 0 | 1.200 | 0.700 |  |

C431540

## C720477 — SW-SMD_L3.9-W3.0-P4.45

reset button on P0.18 (TS-1088-AR02016).
Datasheet: [C720477_TS-1088-AR02016.pdf](../../docs/datasheets/C720477_TS-1088-AR02016.pdf).

| Pad | Type | Shape | x | y | Rot | Width | Height | Drill |
|---|---|---|---|---|---|---|---|---|
| 1 | smd | rect | 2.180 | 0.000 | 0 | 1.230 | 1.860 |  |
| 2 | smd | rect | -2.180 | 0.000 | 0 | 1.230 | 1.860 |  |

C720477

## C409782 — LED-ARRAY-SMD_1206-4P-L3.2-W1.3-BR-EH

reverse-mount RGB LEDs, common anode: status (GPIO) and charge (CHG/PGOOD) (MHT151RGBCT).
Datasheet: [C409782_MHT151RGBCT.pdf](../../docs/datasheets/C409782_MHT151RGBCT.pdf).
Corrected from the datasheet: docs/datasheets/C409782_MHT151RGBCT.pdf p.2, 'Recommended Solder Pad (Reverse Type)': 0.8 x 0.7 mm pads, 2.3 mm between pad rows, 2.1 mm hole. EasyEDA's footprint has the pads 0.2 mm closer together and no hole.

| Pad | Type | Shape | x | y | Rot | Width | Height | Drill |
|---|---|---|---|---|---|---|---|---|
| (hole) | np_thru_hole | circle | -0.000 | 0.000 | 0 | 2.100 | 2.100 | 2.1 |
| 1 | smd | rect | -1.550 | -0.550 | 0 | 0.800 | 0.700 |  |
| 2 | smd | rect | -1.550 | 0.550 | 0 | 0.800 | 0.700 |  |
| 3 | smd | rect | 1.550 | 0.550 | 0 | 0.800 | 0.700 |  |
| 4 | smd | rect | 1.550 | -0.550 | 0 | 0.800 | 0.700 |  |

C409782

## C81598 — SOD-123F_L2.7-W1.6-LS3.8-RD

isolate the CHG and PGOOD GPIO reads from the charge LED's input-side supply (1N4148W).
Datasheet: [C81598_1N4148W.pdf](../../docs/datasheets/C81598_1N4148W.pdf).

| Pad | Type | Shape | x | y | Rot | Width | Height | Drill |
|---|---|---|---|---|---|---|---|---|
| 1 | smd | rect | 1.730 | 0.000 | 0 | 1.100 | 1.000 |  |
| 2 | smd | rect | -1.730 | 0.000 | 0 | 1.100 | 1.000 |  |

C81598

## C25744 — R0402

10k: charger TS (no thermistor).
Datasheet: [C25744_R0402_10k.pdf](../../docs/datasheets/C25744_R0402_10k.pdf).

| Pad | Type | Shape | x | y | Rot | Width | Height | Drill |
|---|---|---|---|---|---|---|---|---|
| 1 | smd | rect | 0.430 | 0.000 | 0 | 0.566 | 0.540 |  |
| 2 | smd | rect | -0.430 | 0.000 | 0 | 0.566 | 0.540 |  |

C25744

## C25905 — R0402

5.1k: USB-C CC1, CC2; charger ILIM, ISET.
Datasheet: [C25905_R0402_5k1.pdf](../../docs/datasheets/C25905_R0402_5k1.pdf).

| Pad | Type | Shape | x | y | Rot | Width | Height | Drill |
|---|---|---|---|---|---|---|---|---|
| 1 | smd | rect | 0.430 | 0.000 | 0 | 0.566 | 0.540 |  |
| 2 | smd | rect | -0.430 | 0.000 | 0 | 0.566 | 0.540 |  |

C25905

## C11702 — R0402

1k: charge LED red and green.
Datasheet: [C11702_R0402_1k.pdf](../../docs/datasheets/C11702_R0402_1k.pdf).

| Pad | Type | Shape | x | y | Rot | Width | Height | Drill |
|---|---|---|---|---|---|---|---|---|
| 1 | smd | rect | 0.430 | 0.000 | 0 | 0.566 | 0.540 |  |
| 2 | smd | rect | -0.430 | 0.000 | 0 | 0.566 | 0.540 |  |

C11702

## C25117 — R0402

470R: status LED red, green, blue.
Datasheet: [C25117_R0402_470R.pdf](../../docs/datasheets/C25117_R0402_470R.pdf).

| Pad | Type | Shape | x | y | Rot | Width | Height | Drill |
|---|---|---|---|---|---|---|---|---|
| 1 | smd | rect | 0.430 | 0.000 | 0 | 0.566 | 0.540 |  |
| 2 | smd | rect | -0.430 | 0.000 | 0 | 0.566 | 0.540 |  |

C25117

## C1525 — C0402

100nF 0402: VDD.
Datasheet: [C1525_C0402_100nF.pdf](../../docs/datasheets/C1525_C0402_100nF.pdf).

| Pad | Type | Shape | x | y | Rot | Width | Height | Drill |
|---|---|---|---|---|---|---|---|---|
| 1 | smd | rect | 0.420 | 0.000 | 0 | 0.500 | 0.540 |  |
| 2 | smd | rect | -0.420 | 0.000 | 0 | 0.500 | 0.540 |  |

C1525

## C15849 — C0603

1uF 50V 0603: charger IN (sees up to 26 V on overvoltage).
Datasheet: [C15849_C0603_1uF_50V.pdf](../../docs/datasheets/C15849_C0603_1uF_50V.pdf).

| Pad | Type | Shape | x | y | Rot | Width | Height | Drill |
|---|---|---|---|---|---|---|---|---|
| 1 | smd | rect | 0.700 | 0.000 | 0 | 0.800 | 0.900 |  |
| 2 | smd | rect | -0.700 | 0.000 | 0 | 0.800 | 0.900 |  |

C15849

## C19666 — C0603

4.7uF 16V 0603: charger OUT, charger BAT, nRF VBUS.
Datasheet: [C19666_C0603_4u7_16V.pdf](../../docs/datasheets/C19666_C0603_4u7_16V.pdf).

| Pad | Type | Shape | x | y | Rot | Width | Height | Drill |
|---|---|---|---|---|---|---|---|---|
| 1 | smd | rect | 0.700 | 0.000 | 0 | 0.800 | 0.900 |  |
| 2 | smd | rect | -0.700 | 0.000 | 0 | 0.800 | 0.900 |  |

C19666

## C19702 — C0603

10uF 10V 0603: VDDH bulk.
Datasheet: [C19702_C0603_10uF_10V.pdf](../../docs/datasheets/C19702_C0603_10uF_10V.pdf).

| Pad | Type | Shape | x | y | Rot | Width | Height | Drill |
|---|---|---|---|---|---|---|---|---|
| 1 | smd | rect | 0.700 | 0.000 | 0 | 0.800 | 0.900 |  |
| 2 | smd | rect | -0.700 | 0.000 | 0 | 0.800 | 0.900 |  |

C19702

## BAT_PADS — BAT_PADS

custom pads (scripts/parts/custom_parts.py).
No datasheet (custom pads).

| Pad | Type | Shape | x | y | Rot | Width | Height | Drill |
|---|---|---|---|---|---|---|---|---|
| 1 | smd | rect | -2.000 | 0.000 | 0 | 2.000 | 3.000 |  |
| 2 | smd | rect | 2.000 | 0.000 | 0 | 2.000 | 3.000 |  |

BAT_PADS

## DOCK_PADS — DOCK_PADS

custom pads (scripts/parts/custom_parts.py).
No datasheet (custom pads).

| Pad | Type | Shape | x | y | Rot | Width | Height | Drill |
|---|---|---|---|---|---|---|---|---|
| 1 | smd | rect | 4.000 | 0.000 | 0 | 2.500 | 4.000 |  |
| 2 | smd | rect | -0.000 | 0.000 | 0 | 2.500 | 4.000 |  |
| 3 | smd | rect | -4.000 | 0.000 | 0 | 2.500 | 4.000 |  |

DOCK_PADS

## SWD_PADS — SWD_PADS

custom pads (scripts/parts/custom_parts.py).
No datasheet (custom pads).

| Pad | Type | Shape | x | y | Rot | Width | Height | Drill |
|---|---|---|---|---|---|---|---|---|
| 1 | smd | circle | 5.080 | 0.000 | 0 | 1.500 | 1.500 |  |
| 2 | smd | circle | 2.540 | 0.000 | 0 | 1.500 | 1.500 |  |
| 3 | smd | circle | -0.000 | 0.000 | 0 | 1.500 | 1.500 |  |
| 4 | smd | circle | -2.540 | 0.000 | 0 | 1.500 | 1.500 |  |
| 5 | smd | circle | -5.080 | 0.000 | 0 | 1.500 | 1.500 |  |

SWD_PADS
