brancz/urchin-plus-plus/reports/phase0/roundtrip/versions.txt

date_utc: 2026-10-18T10:34:19Z
kicad-cli: 9.0.9
pcbnew: 9.0.9
kikit: 1.8.1
atopile: 0.15.7
freerouting.jar sha256: f6f51bb02245e8e717f9359bd260cc9c5c0b1bc0acc8b7cb2cd5b8ffeb5de3c7
java: openjdk version "27" 2026-09-15
bash: 3.2.57(1)-release
