brancz/urchin-plus-plus/reports/phase3/placement-left-bottom.png

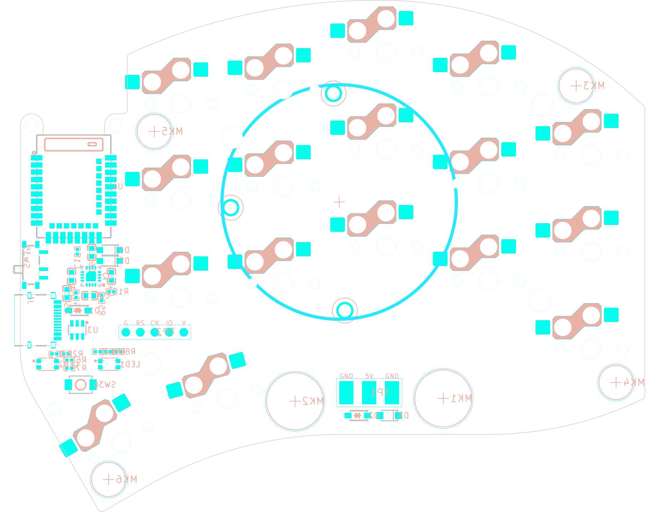
reports/phase3/placement-left-bottom.png
