brancz/urchin-plus-plus/reports/phase3/placement-left-top.png

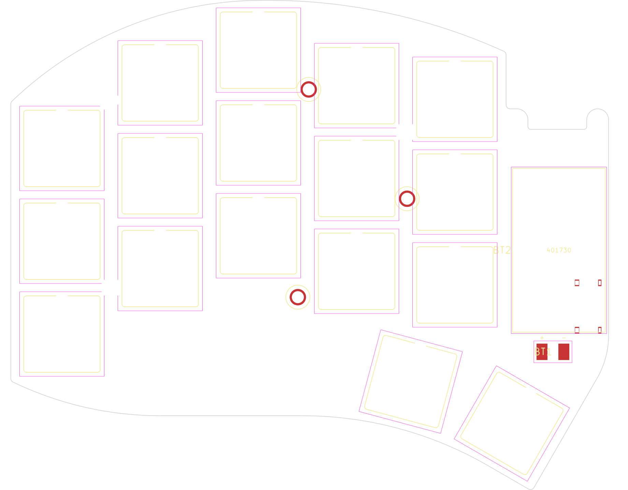
reports/phase3/placement-left-top.png
