brancz/urchin-plus-plus/reports/phase3/placement-right-bottom.png

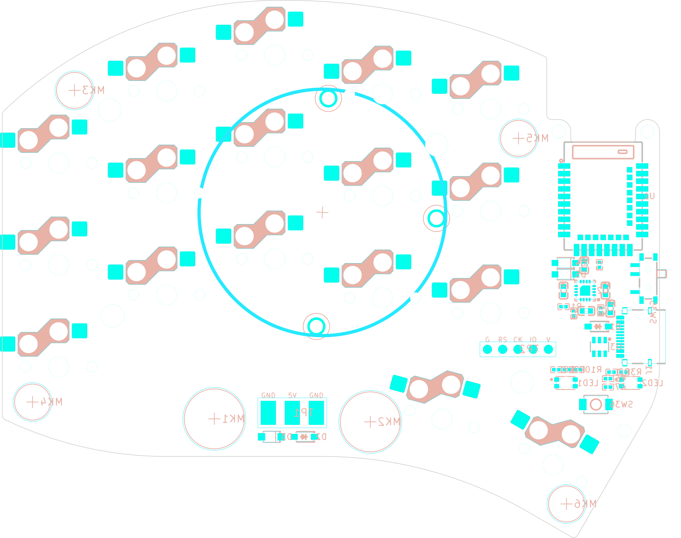
reports/phase3/placement-right-bottom.png
