brancz/urchin-plus-plus/reports/phase3/placement-right-top.png

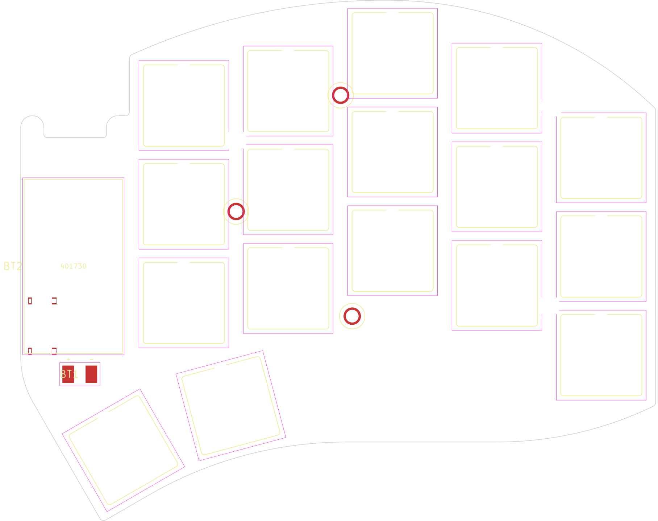
reports/phase3/placement-right-top.png
