brancz/urchin-plus-plus/reports/phase3/render-left-bottom.png

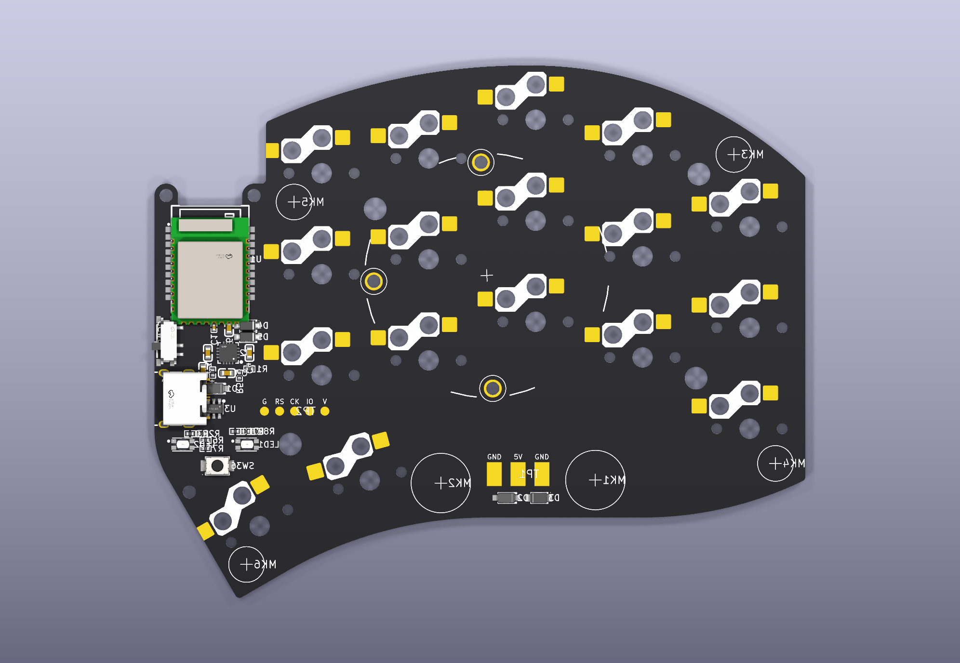
reports/phase3/render-left-bottom.png
