brancz/urchin-plus-plus/reports/phase3/render-right-bottom.png

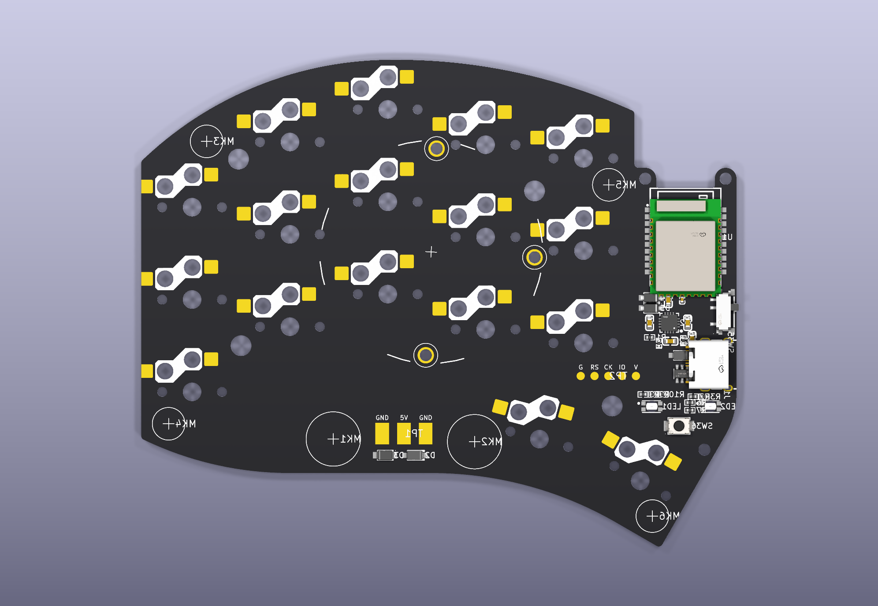
reports/phase3/render-right-bottom.png
