brancz/urchin-plus-plus/reports/phase3/render-right-top.png

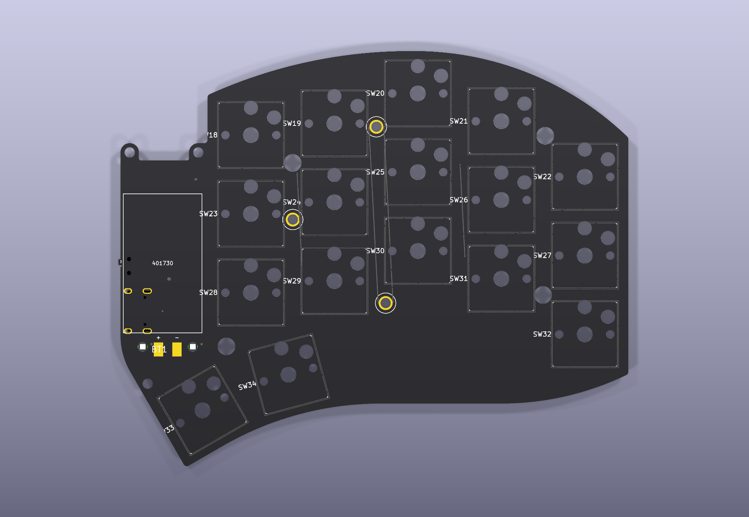
reports/phase3/render-right-top.png
