brancz/urchin-plus-plus/reports/phase4/copper-left-B_Cu.png

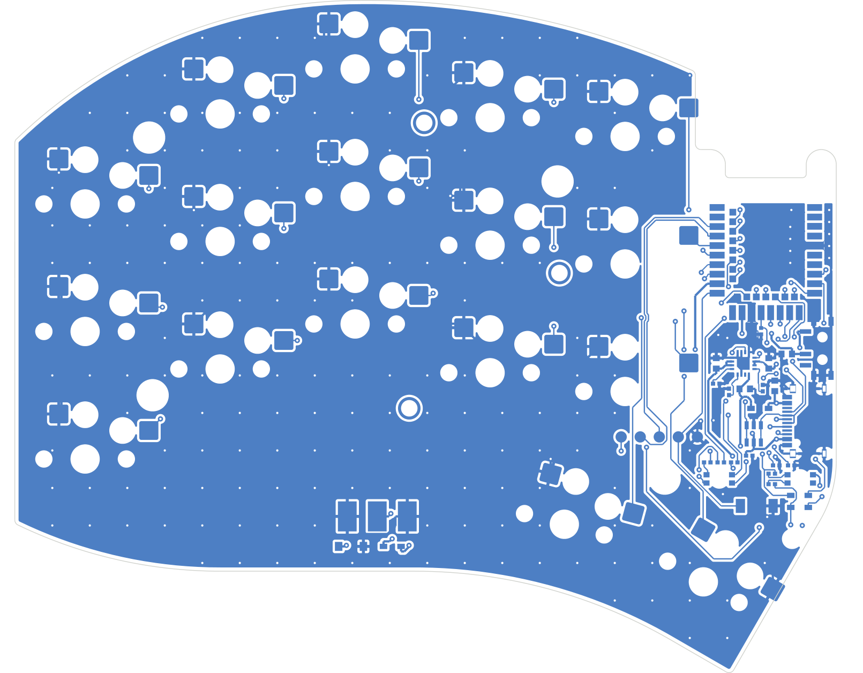
reports/phase4/copper-left-B_Cu.png
