brancz/urchin-plus-plus/reports/phase4/copper-left-both.png

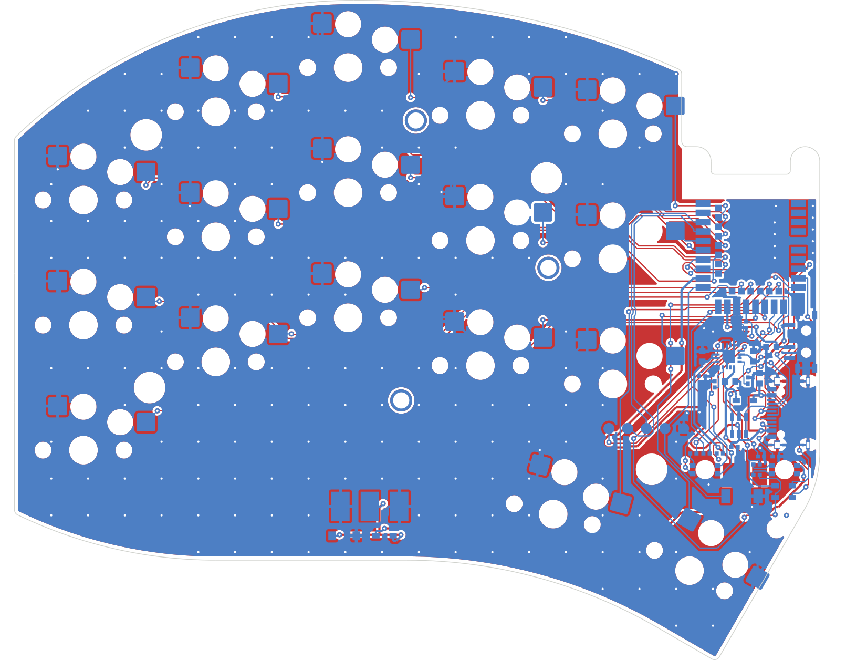
reports/phase4/copper-left-both.png
