brancz/urchin-plus-plus/reports/phase4/copper-right-B_Cu.png

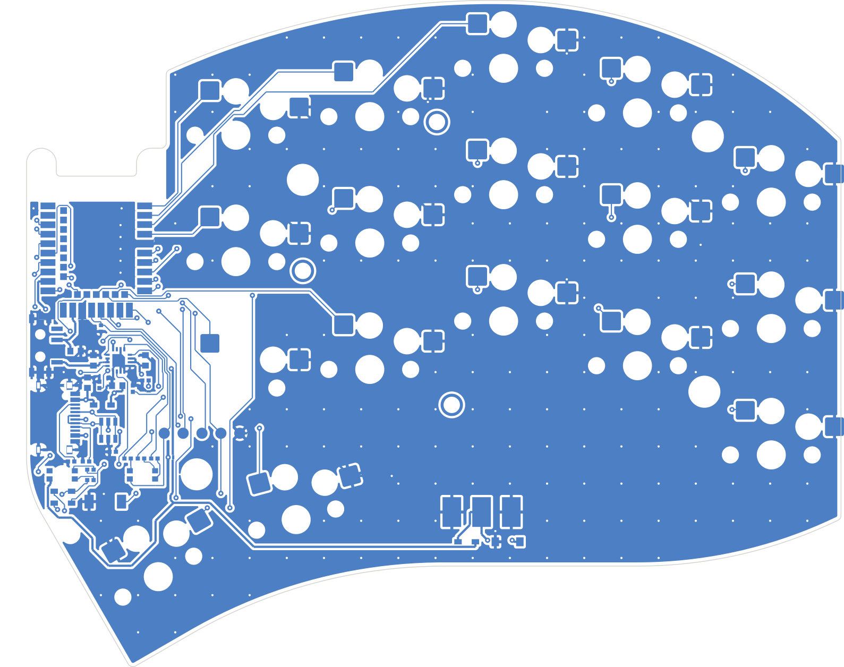
reports/phase4/copper-right-B_Cu.png
