brancz/urchin-plus-plus/reports/phase4/copper-right-both.png

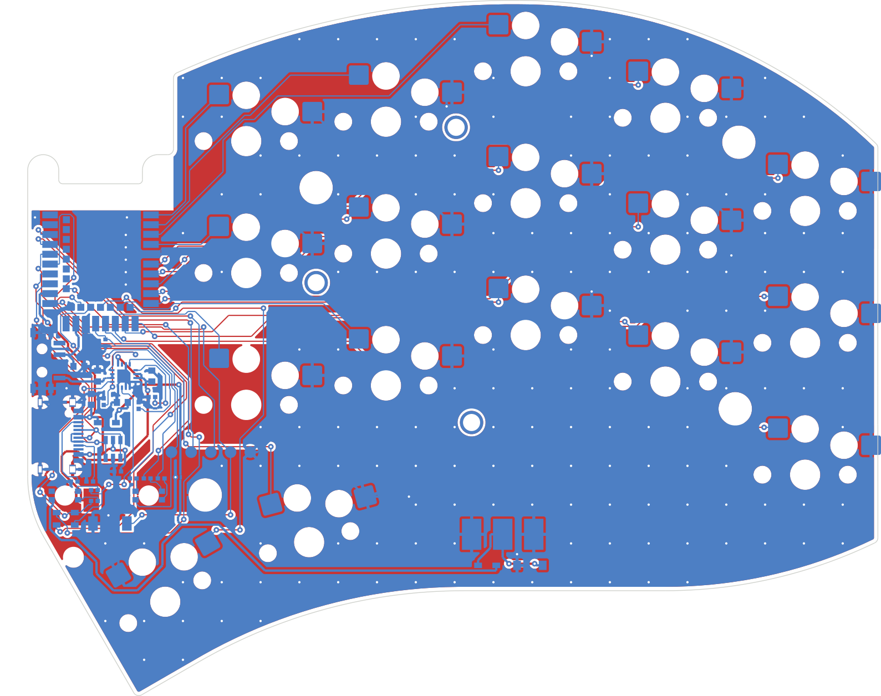
reports/phase4/copper-right-both.png
