brancz/urchin-plus-plus/reports/phase6/jlc-placement/left-controller.png

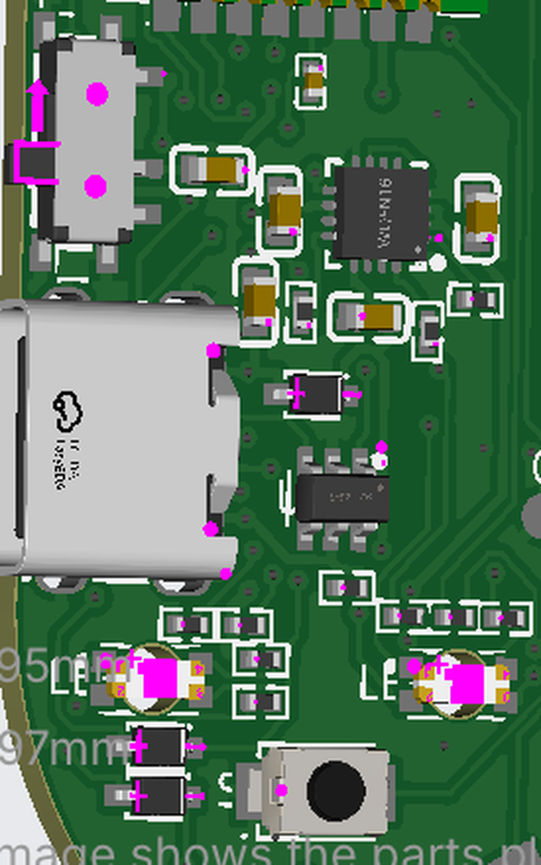
reports/phase6/jlc-placement/left-controller.png
