brancz/urchin-plus-plus/reports/phase6/jlc-placement/right-controller.png

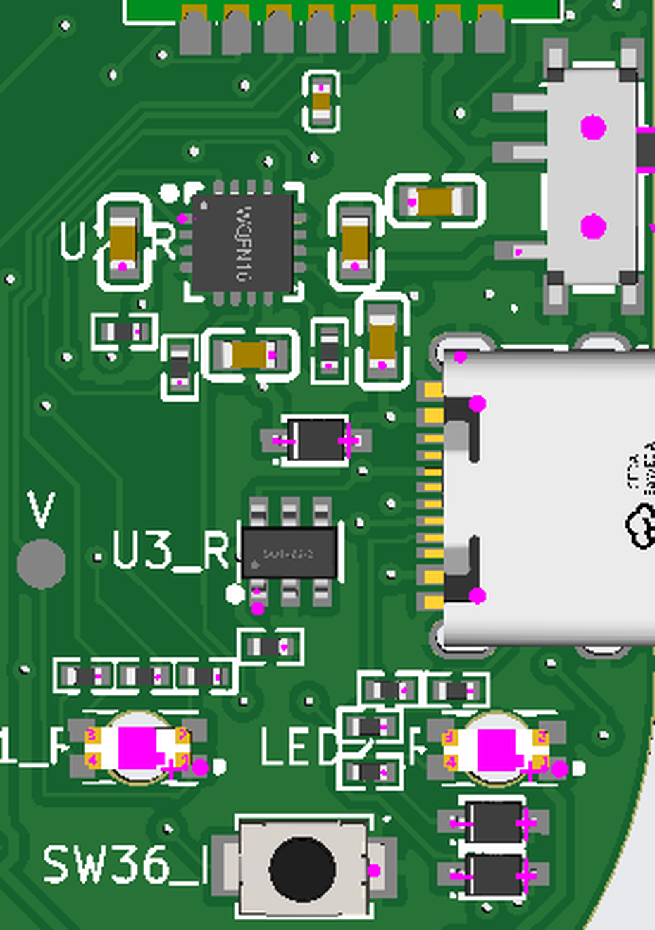
reports/phase6/jlc-placement/right-controller.png
