brancz/urchin-plus-plus/reports/phase6/panel-bottom.png

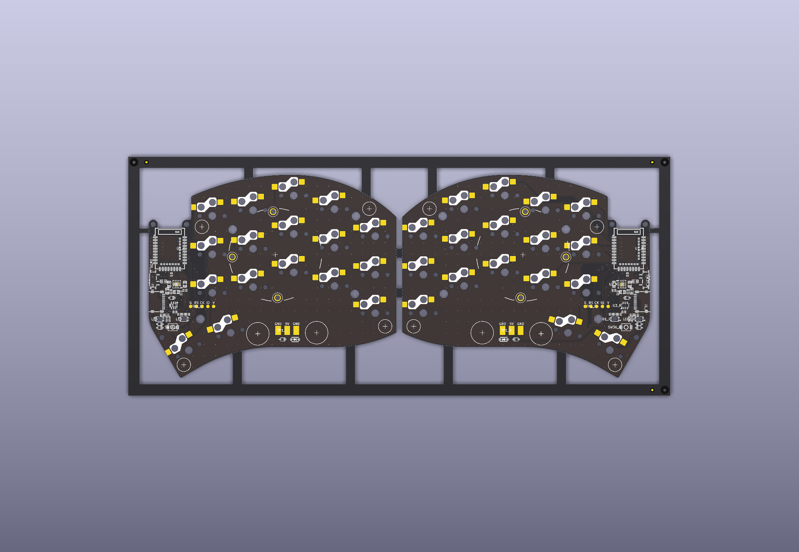
reports/phase6/panel-bottom.png
