brancz/urchin-plus-plus/reports/phase7/dock/dock-bottom.png

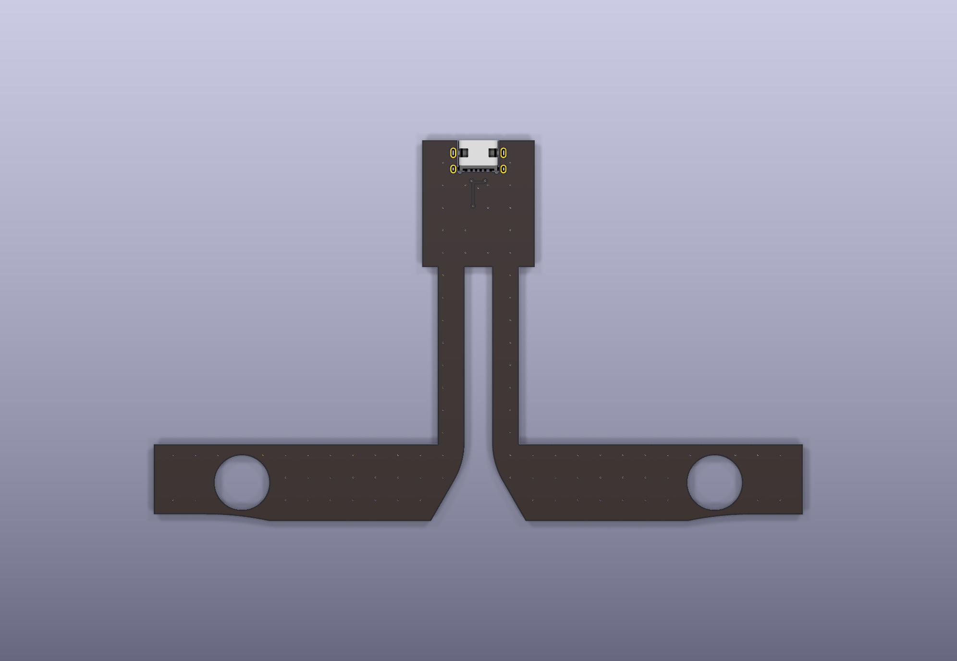
reports/phase7/dock/dock-bottom.png
