brancz/urchin-plus-plus/reports/phase7/render/case_left-iso.png

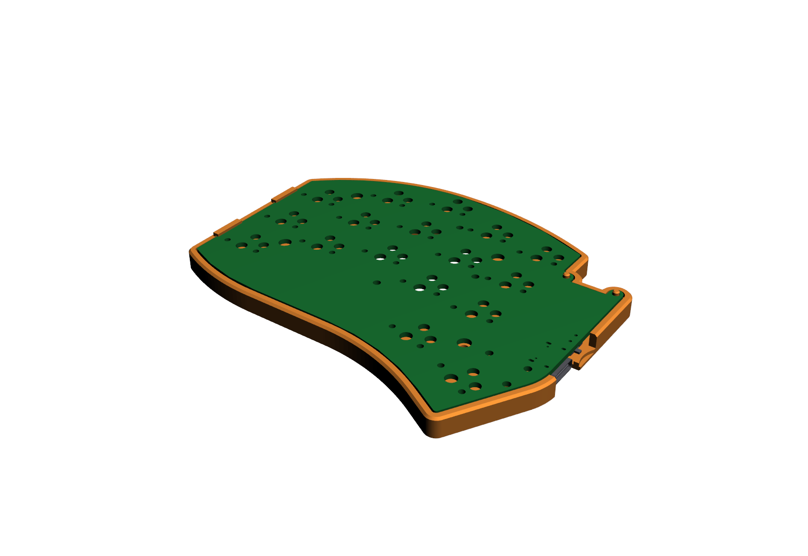
reports/phase7/render/case_left-iso.png
