brancz/urchin-plus-plus/reports/phase7/render/case_left-under.png

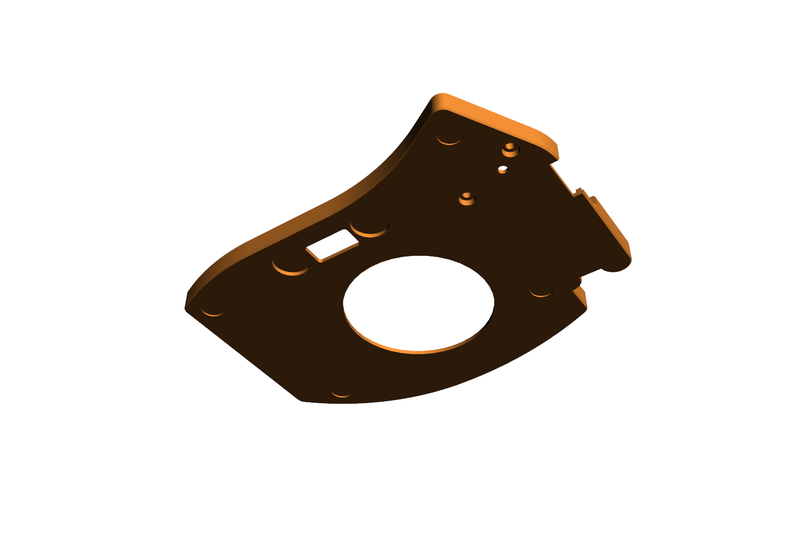
reports/phase7/render/case_left-under.png
