brancz/urchin-plus-plus/reports/phase7/render/case_right-under.png

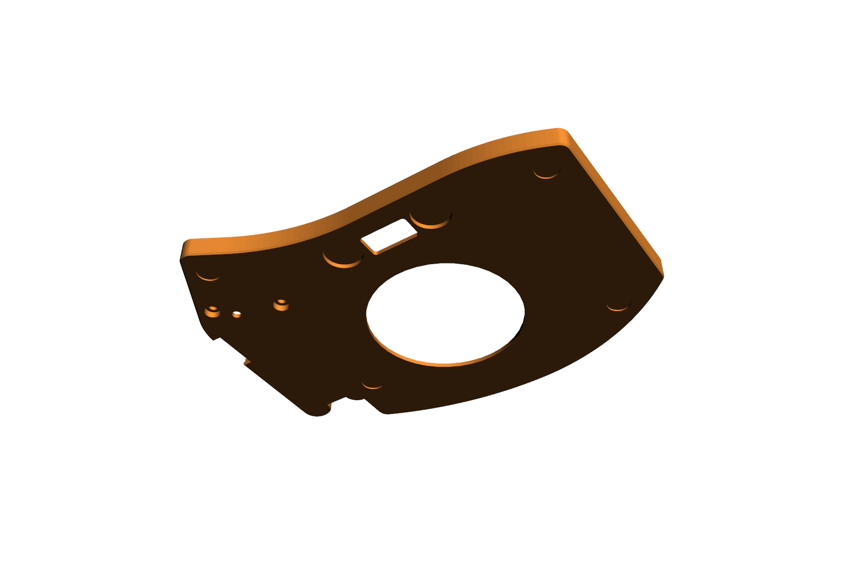
reports/phase7/render/case_right-under.png
