brancz/urchin-plus-plus/reports/phase7/render/dock-iso.png

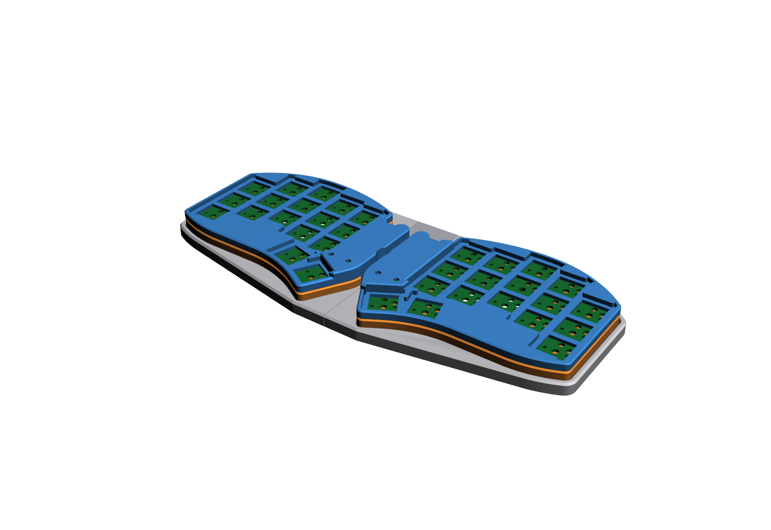
reports/phase7/render/dock-iso.png
