brancz/urchin-plus-plus/reports/phase7/render/dock-pin-section.png

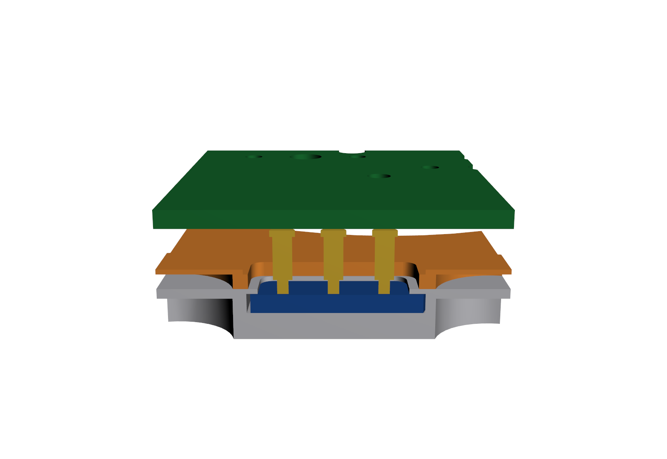
reports/phase7/render/dock-pin-section.png
