brancz/urchin-plus-plus/reports/phase7/render/dock_cover-under.png

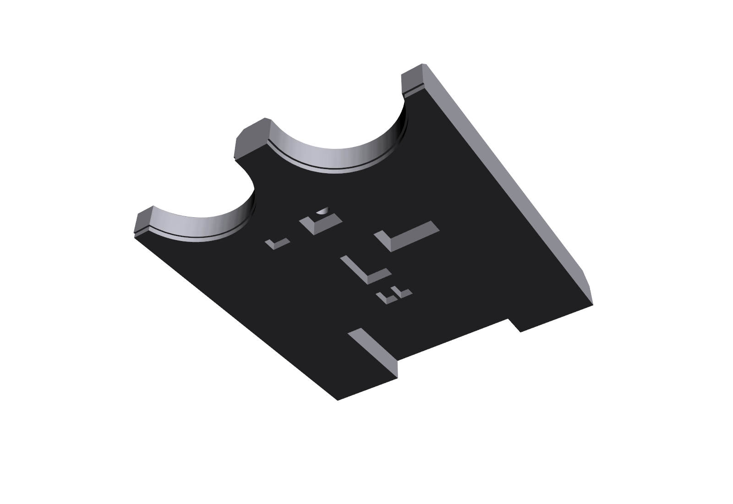
reports/phase7/render/dock_cover-under.png
