brancz/urchin-plus-plus/reports/phase7/render/left-inner-edge.png

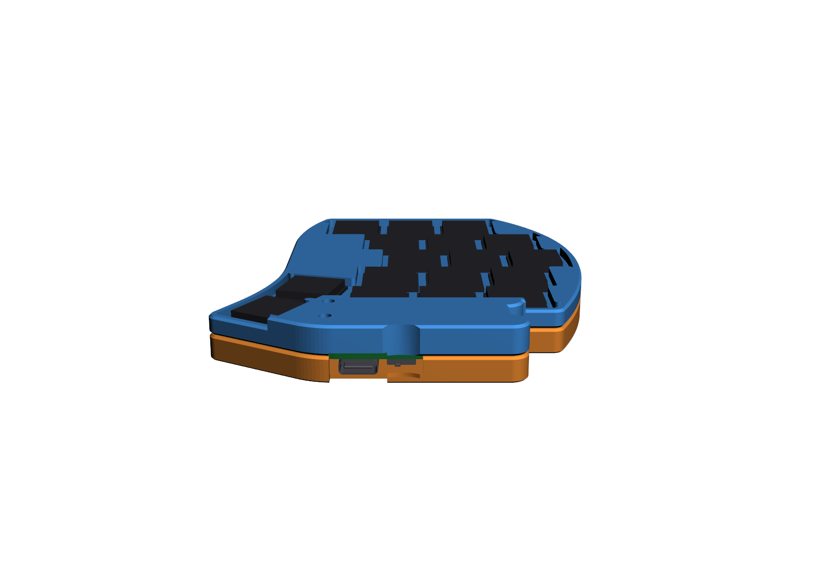
reports/phase7/render/left-inner-edge.png
