brancz/urchin-plus-plus/reports/phase7/render/shell_left-iso.png

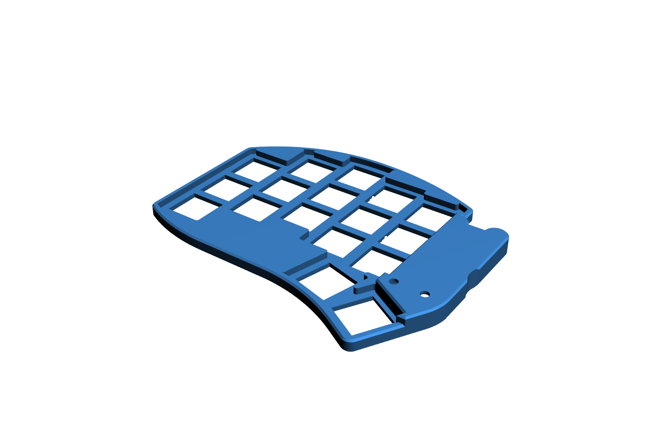
reports/phase7/render/shell_left-iso.png
