brancz/urchin-plus-plus/reports/phase7/render/shell_right-iso.png

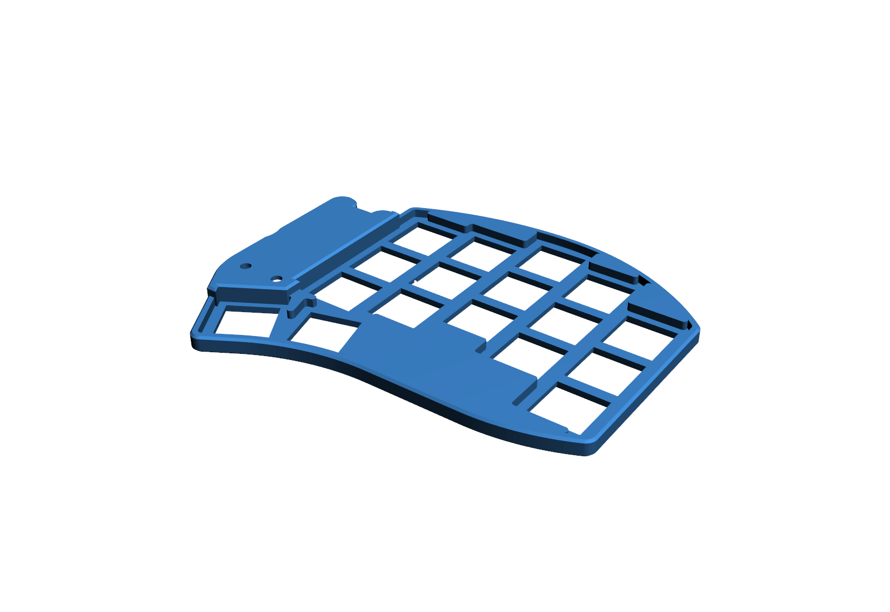
reports/phase7/render/shell_right-iso.png
