brancz/urchin-plus-plus/reports/phase7/render/shell_right-under.png

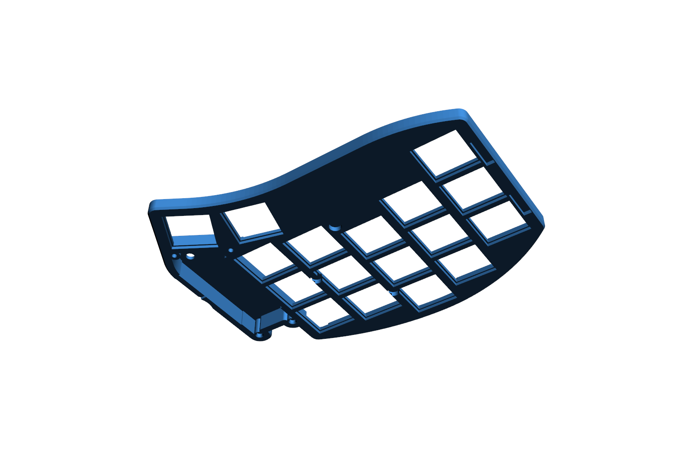
reports/phase7/render/shell_right-under.png
