brancz/urchin-plus-plus/reports/phase7/render/tray-top.png

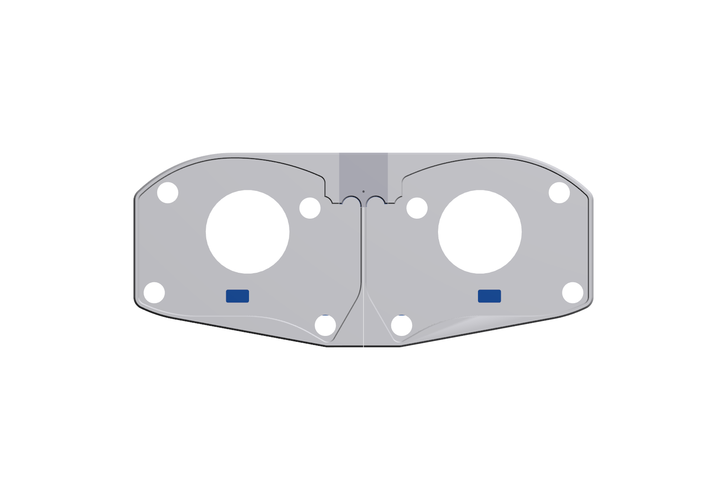
reports/phase7/render/tray-top.png
