brancz/urchin-plus-plus/reports/phase7/render/tray-under.png

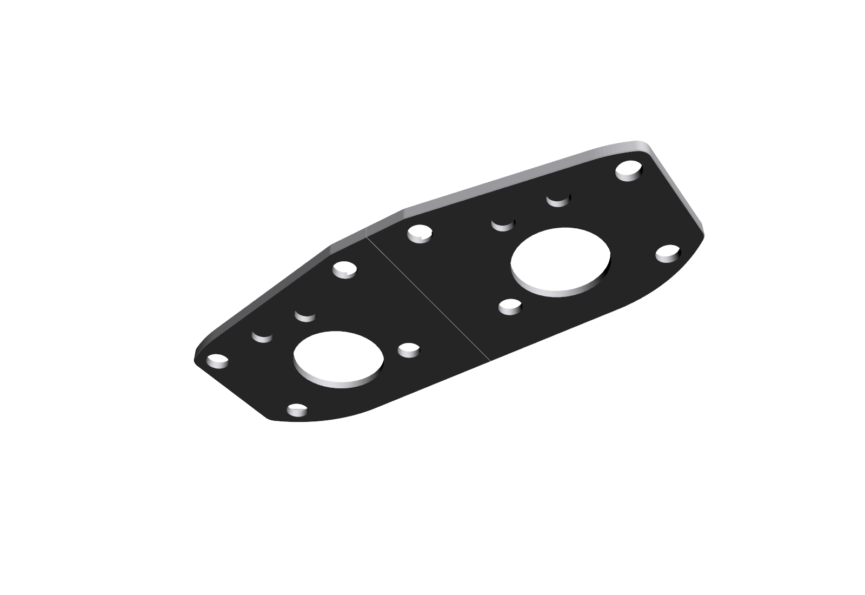
reports/phase7/render/tray-under.png
