brancz/urchin-plus-plus/reports/phase7/dock-bom.md

# BOM stock check: dock

Checked against the JLC assembly library at 2026-10-25T13:57:41Z, for 5 dock boards. Quantities are per board.

| LCSC | Part | Manufacturer | Package | Library | Qty/board | Needed | JLC stock | Role | Datasheet |
|---|---|---|---|---|---|---|---|---|---|
| C2848622 | TYPE-C-31-M-28A | Korean Hroparts Elec | SMD | extended | 1 | 5 | 15510 | USB-C receptacle, power only, mid-mount (HRO TYPE-C-31-M-28A): its body sinks into a notch in the board, 1.58 mm above and below its top | [pdf](../../docs/datasheets/C2848622_TYPE-C-31-M-28A.pdf) |
| C75464 | MF-NSMF050-2 | BOURNS | 1206 | extended | 1 | 5 | 72279 | Resettable fuse 0.5 A hold (Bourns MF-NSMF050-2) | [pdf](../../docs/datasheets/C75464_MF-NSMF050-2.pdf) |
| C123790 | SMF6.0A | MDD(Microdiode Semiconductor) | SOD-123FL | extended | 1 | 5 | 113999 | 5V TVS, 6.0 V standoff (MDD SMF6.0A) | [pdf](../../docs/datasheets/C123790_SMF6.0A.pdf) |
| C25905 | 0402WGF5101TCE | UNI-ROYAL(Uniroyal Elec) | 0402 | basic | 2 | 10 | 4224758 | 5.1k CC pull-downs, one per CC pin | [pdf](../../docs/datasheets/C25905_R0402_5k1.pdf) |
| C2297 | KT-0805G | Hubei KENTO Elec | 0805 | basic | 1 | 5 | 2413575 | Power LED, green 0805 (KENTO KT-0805G) | [pdf](../../docs/datasheets/C2297_KT-0805G.pdf) |
| C25879 | 0402WGF2201TCE | UNI-ROYAL(Uniroyal Elec) | 0402 | basic | 1 | 5 | 3014078 | 2.2k LED resistor | [pdf](../../docs/datasheets/C25879_R0402_2k2.pdf) |

Problems: none
