brancz/urchin-plus-plus/reports/phase6/bom.csv

Comment | Designator | Footprint | LCSC Part #
0402WGF1001TCE | R6_L,R6_R,R7_L,R7_R | R0402 | C11702
SMF6.0A | D3_L,D3_R | SOD-123F_L2.8-W1.8-LS3.7-RD | C123790
BQ24073RGTR | U2_L,U2_R | QFN-16_L3.0-W3.0-P0.50-TL-EP1.7 | C15220
CL10A105KB8NNNC | C2_L,C2_R | C0603 | C15849
TYPE-C-31-M-12 | J1_L,J1_R | USB-C_SMD-TYPE-C-31-M-12_1 | C165948
1N5819WS | D1_L,D1_R,D2_L,D2_R,D4_L,D4_R,D5_L,D5_R | SOD-323_L1.8-W1.3-LS2.5-RD | C191023
CL10A475KO8NNNC | C5_L,C5_R | C0603 | C19666
CL10A106KP8NNNC | C3_L,C3_R,C4_L,C4_R,C6_L,C6_R | C0603 | C19702
CL05A475MP5NRNC | C1_L,C1_R | C0402 | C23733
0402WGF2200TCE | R10_L,R10_R,R9_L,R9_R | R0402 | C25091
0402WGF4700TCE | R8_L,R8_R | R0402 | C25117
0402WGF1002TCE | R11_L,R11_R,R1_L,R1_R | R0402 | C25744
0402WGF5101TCE | R2_L,R2_R,R3_L,R3_R,R4_L,R4_R,R5_L,R5_R | R0402 | C25905
E73-2G4M08S1C | U1_L,U1_R | WIRELM-SMD_E73-2G4M08S1C | C356849
MHT151RGBCT | LED1_L,LED1_R,LED2_L,LED2_R | LED-ARRAY-SMD_1206-4P-L3.2-W1.3-BR-EH | C409782
MSK12C02 | SW35_L,SW35_R | SW-TH_MSK12C02 | C431540
TS-1088-AR02016 | SW36_L,SW36_R | SW-SMD_L3.9-W3.0-P4.45 | C720477
USBLC6-2SC6 | U3_L,U3_R | SOT-23-6_L2.9-W1.6-P0.95-LS2.8-BL | C7519
