brancz/urchin-plus-plus/reports/phase7/dock/bom.csv

Comment | Designator | Footprint | LCSC Part #
SMF6.0A | D1 | SOD-123F_L2.8-W1.8-LS3.7-RD | C123790
KT-0805G | LED1 | LED0805-R-RD | C2297
0402WGF2201TCE | R3 | R0402 | C25879
0402WGF5101TCE | R1,R2 | R0402 | C25905
TYPE-C-31-M-28A | J1 | TYPE-C-SMD_TYPE-C-31-M-28A | C2848622
MF-NSMF050-2 | F1 | F1206 | C75464
