brancz/urchin-plus-plus/dock-pcb/parts/C123790/SOD-123FL_L2.8-W1.8-LS3.7-RD-1.step

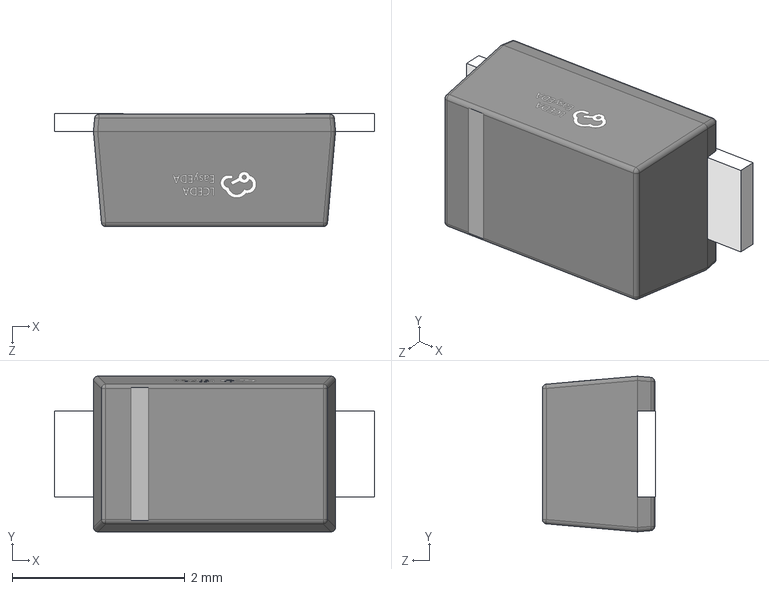
[picture p30: CAD file, 2026-10-18]
dock-pcb/parts/C123790/SOD-123FL_L2.8-W1.8-LS3.7-RD-1.step
3.70 x 1.80 x 1.31 mm
