brancz/urchin-plus-plus/dock-pcb/parts/C2297/LED0805-RD.step

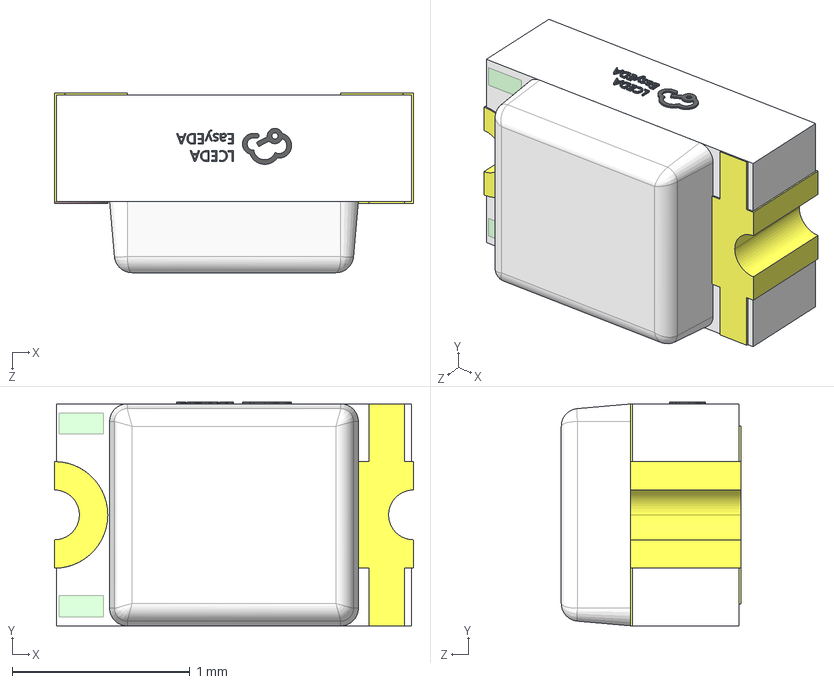
[picture p31: CAD file, 2026-10-24]
dock-pcb/parts/C2297/LED0805-RD.step
2.02 x 1.26 x 1.01 mm
