brancz/urchin-plus-plus/dock-pcb/parts/C25879/R0402_L1.0-W0.5-H0.4.step

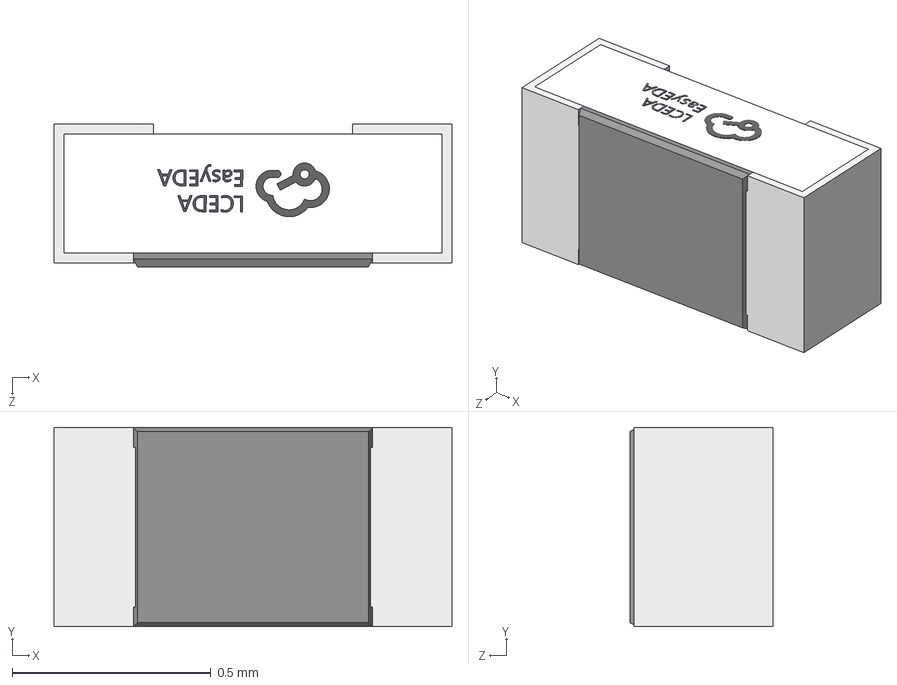
[picture p32: CAD file, 2026-10-17]
dock-pcb/parts/C25879/R0402_L1.0-W0.5-H0.4.step
1.00 x 0.501 x 0.36 mm
