brancz/urchin-plus-plus/dock-pcb/parts/C2848622/TYPE-C-SMD_TYPE-C-31-M-28A.step

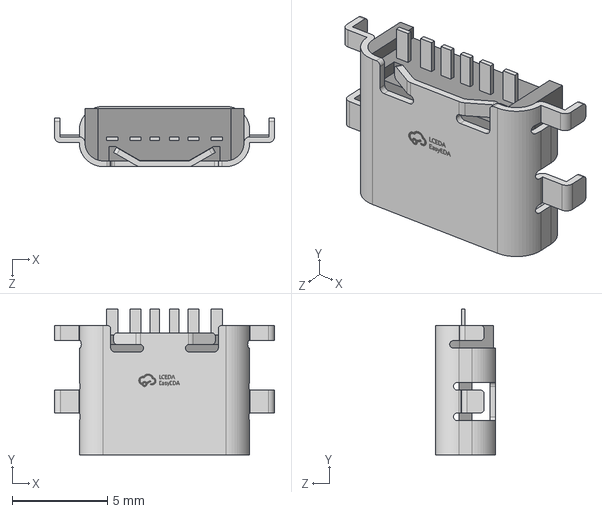
[picture p33: CAD file, 2026-10-25]
dock-pcb/parts/C2848622/TYPE-C-SMD_TYPE-C-31-M-28A.step
11.5 x 7.65 x 3.16 mm
