brancz/urchin-plus-plus/dock-pcb/parts/C75464/F1206_L3.2-W1.7-H0.6.step

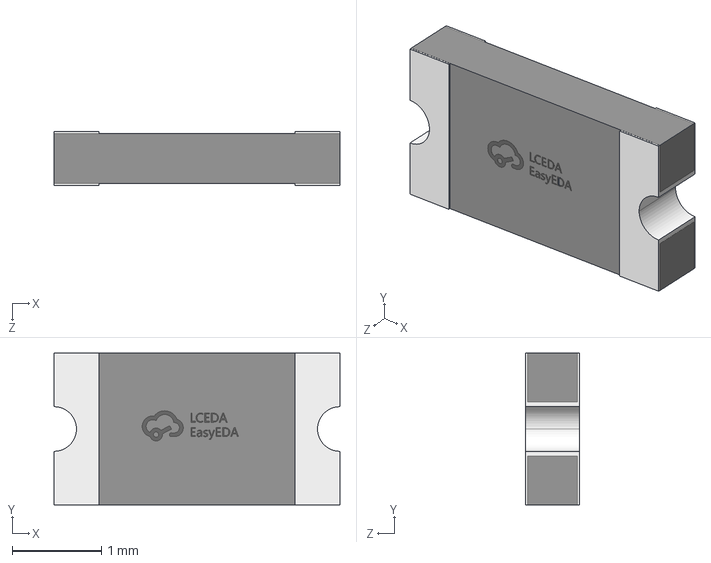
[picture p34: CAD file, 2026-10-24]
dock-pcb/parts/C75464/F1206_L3.2-W1.7-H0.6.step
3.20 x 1.70 x 0.6 mm
