brancz/urchin-plus-plus/hardware/parts/C15220/QFN-16_L3.0-W3.0-P0.50-EP1.7.step

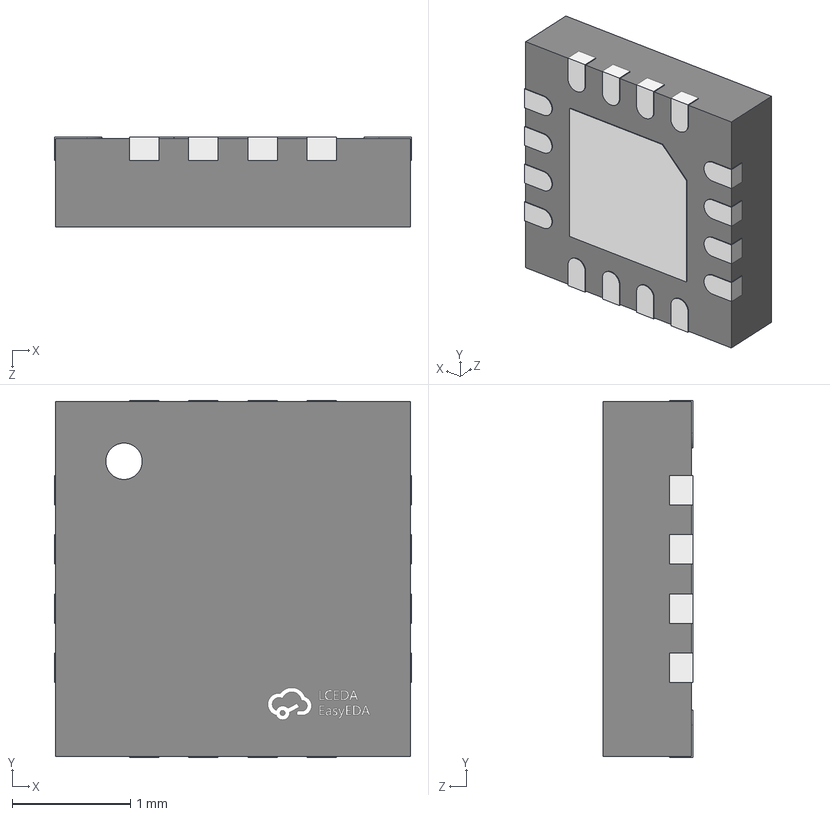
[picture p35: CAD file, 2026-10-18]
hardware/parts/C15220/QFN-16_L3.0-W3.0-P0.50-EP1.7.step
3.02 x 3.02 x 0.76 mm
