brancz/urchin-plus-plus/hardware/parts/C15849/C0603_L1.6-W0.8-H0.8.step

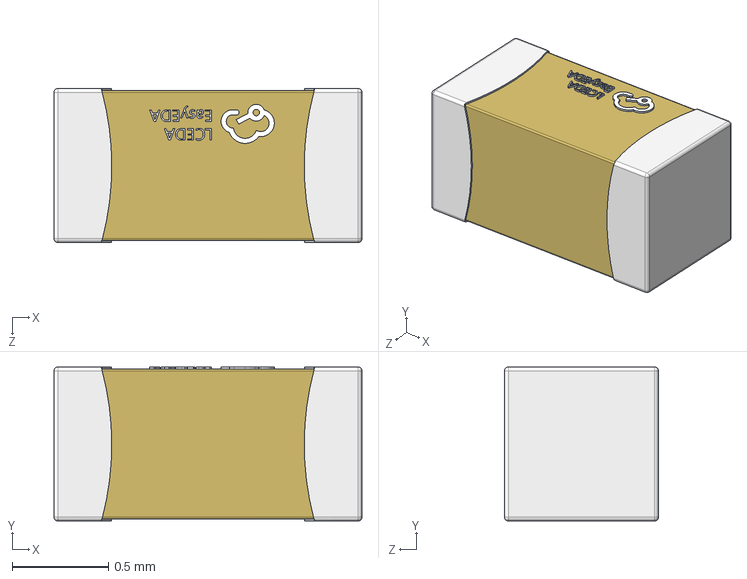
[picture p36: CAD file, 2026-10-18]
hardware/parts/C15849/C0603_L1.6-W0.8-H0.8.step
1.60 x 0.8 x 0.8 mm
