brancz/urchin-plus-plus/hardware/parts/C165948/USB-C_SMD-TYPE-C-31-M-12_1.step

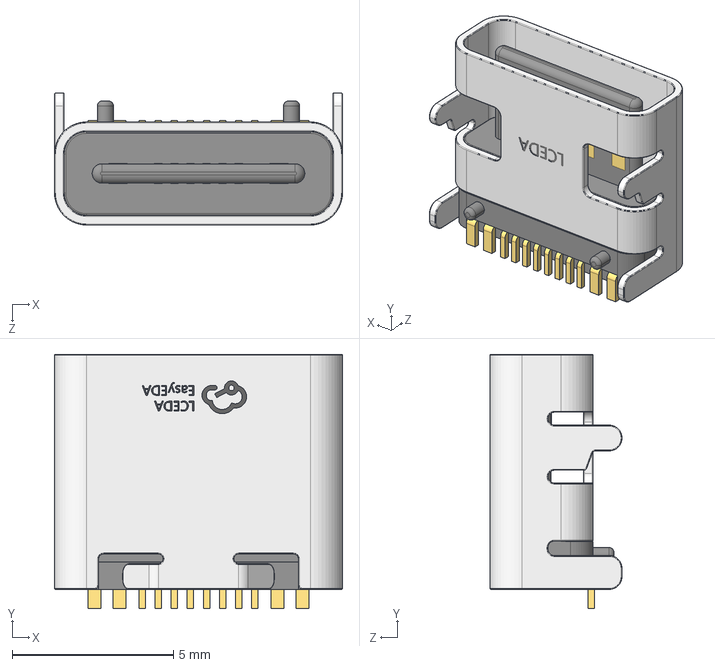
[picture p37: CAD file, 2026-10-18]
hardware/parts/C165948/USB-C_SMD-TYPE-C-31-M-12_1.step
8.94 x 7.90 x 4.10 mm
