brancz/urchin-plus-plus/hardware/parts/C191023/SOD-323_L1.8-W1.3-LS2.5-RD.step

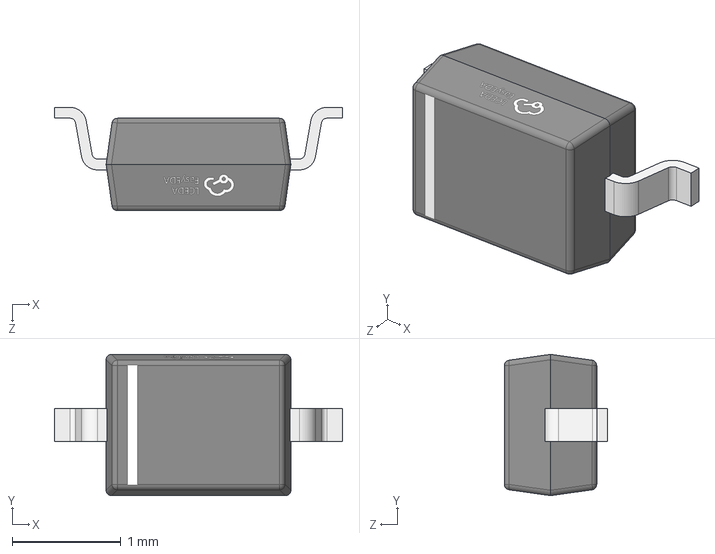
[picture p38: CAD file, 2026-10-19]
hardware/parts/C191023/SOD-323_L1.8-W1.3-LS2.5-RD.step
2.65 x 1.30 x 0.95 mm
