brancz/urchin-plus-plus/hardware/parts/C23733/C0402_L1.0-W0.5-H0.5.step

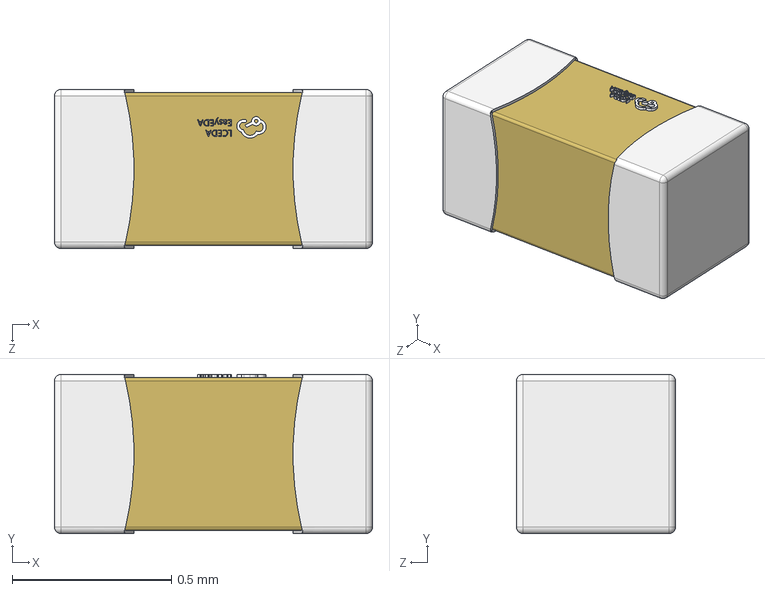
[picture p39: CAD file, 2026-10-17]
hardware/parts/C23733/C0402_L1.0-W0.5-H0.5.step
1.00 x 0.5 x 0.5 mm
