brancz/urchin-plus-plus/hardware/parts/C356849/WIRELM-SMD_L18.0-W13.0-H3.0-E73-2G4M08S1C.step

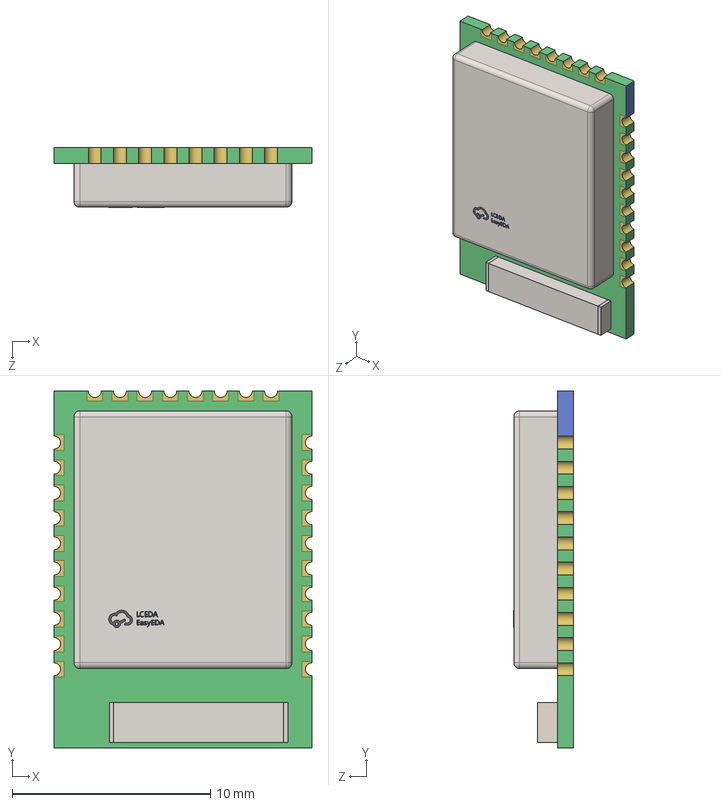
[picture p40: CAD file, 2026-10-18]
hardware/parts/C356849/WIRELM-SMD_L18.0-W13.0-H3.0-E73-2G4M08S1C.step
13.0 x 18.0 x 3.00 mm
