brancz/urchin-plus-plus/hardware/parts/C409782/LED-SMD-1206-4P_L3.2-W1.3-H1.1.step

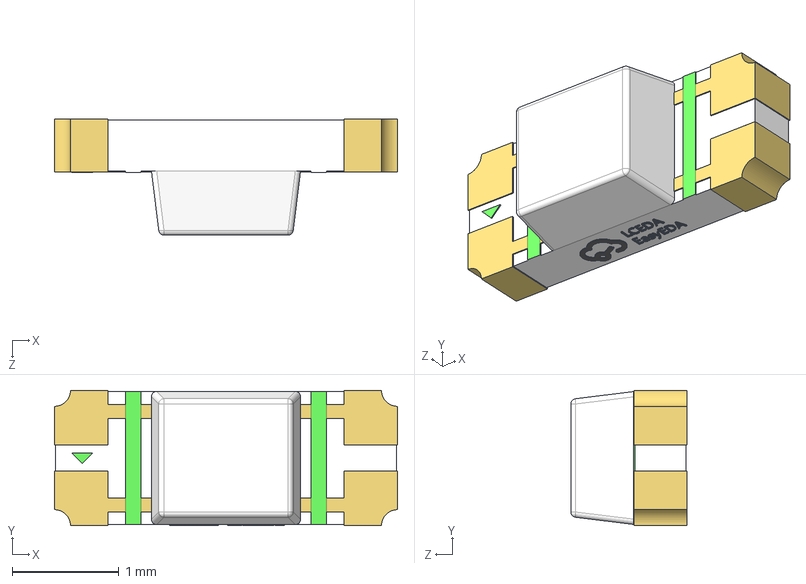
[picture p41: CAD file, 2026-10-18]
hardware/parts/C409782/LED-SMD-1206-4P_L3.2-W1.3-H1.1.step
3.22 x 1.27 x 1.09 mm
