brancz/urchin-plus-plus/hardware/parts/C431540/SW-SMD_3P-L6.6-W2.7-LS7.8-P1.50.step

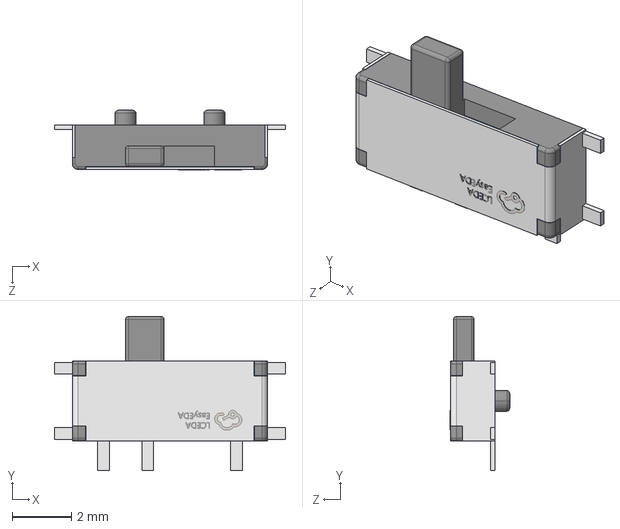
[picture p42: CAD file, 2026-10-18]
hardware/parts/C431540/SW-SMD_3P-L6.6-W2.7-LS7.8-P1.50.step
7.80 x 5.20 x 2.01 mm
