brancz/urchin-plus-plus/hardware/parts/C720477/SW-SMD_L3.9-W2.9-H2.0-LS4.8.step

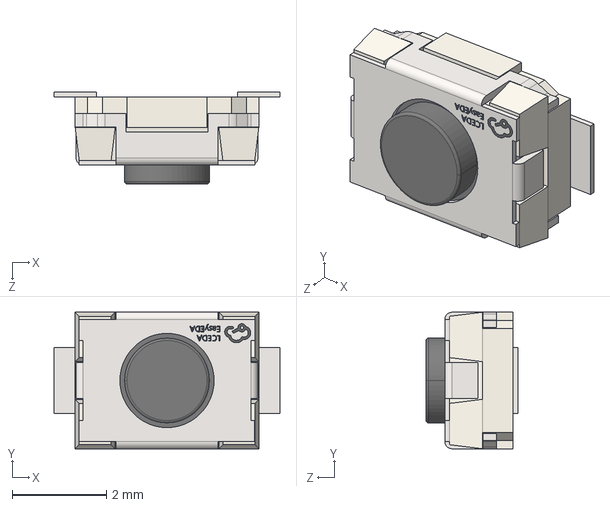
[picture p43: CAD file, 2026-10-18]
hardware/parts/C720477/SW-SMD_L3.9-W2.9-H2.0-LS4.8.step
4.80 x 2.90 x 1.95 mm
