brancz/urchin-plus-plus/reports/phase0/roundtrip/nets_7_after_build.txt

	(net 1 "VCC")
	(net 3 "MID")
	(net 4 "GND")
	(net 5 "FOO")
