brancz/urchin-plus-plus/reports/phase7/render/left-assembly-top.png

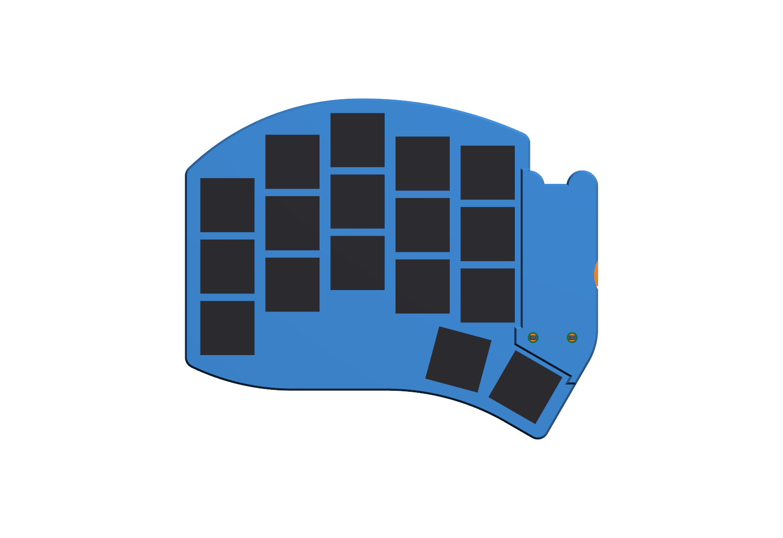
reports/phase7/render/left-assembly-top.png
