brancz/urchin-plus-plus/reports/phase7/render/right-assembly-top.png

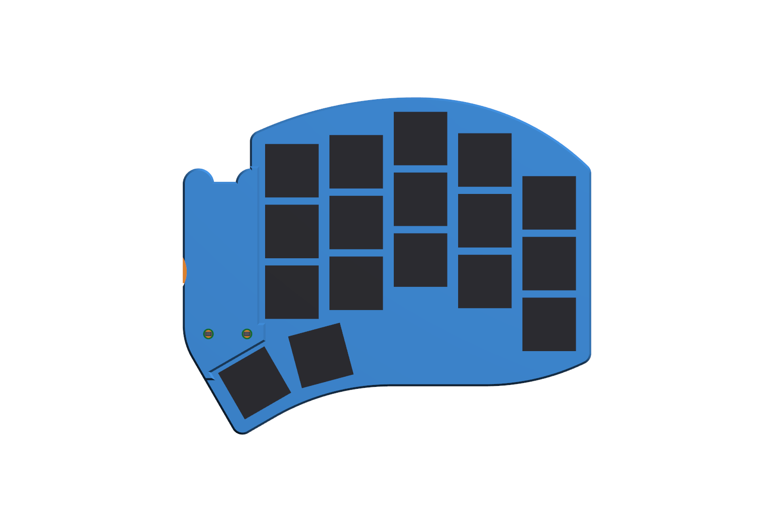
reports/phase7/render/right-assembly-top.png
