brancz/urchin-plus-plus/(list of files, drawings)

Other design files:
.agents/skills/easyeda-api/package-lock.json
.agents/skills/easyeda-api/package.json
