brancz/urchin-plus-plus/dock-pcb/layouts/dock/dock.kicad_pcb

## KiCad design dock-pcb/layouts/dock/dock.kicad_pcb (2026-10-25)

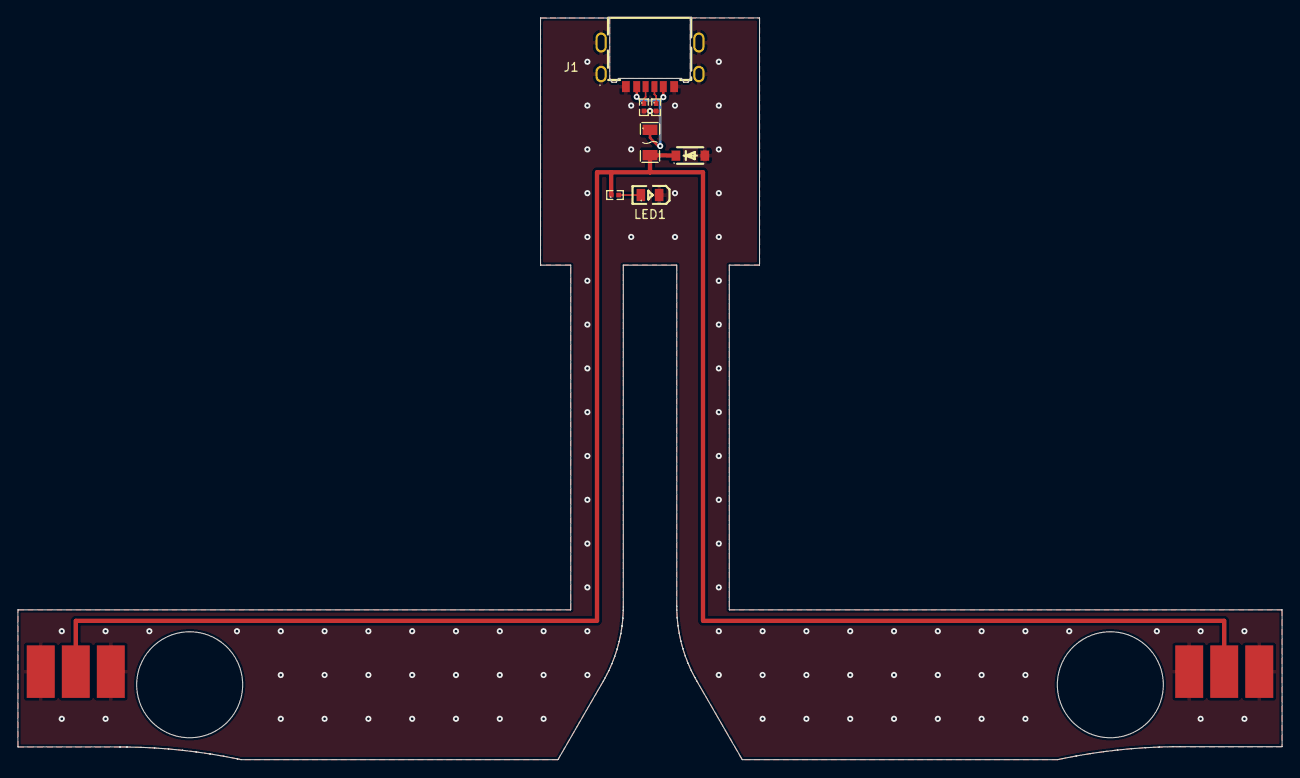
[picture p47: board dock.kicad_pcb from above]

Board: 2 copper layers, 144.3 x 84.7 mm, 9 parts (0 on the bottom side), 6 nets.

Parts:
D1: SOD-123F_L2.8-W1.8-LS3.7-RD
F1: F1206
J1: TYPE-C-SMD_TYPE-C-31-M-28A
LED1: LED0805-R-RD
R1, R2, R3: R0402
TP1, TP2: DOCK_CONTACTS

Connections:
CC1: J1.A5, R1.1
CC2: J1.B5, R2.1
DOCK_5V: D1.1, F1.2, R3.1, TP1.2, TP2.2
GND: D1.2, J1.7, J1.8, J1.9, J1.10, J1.A12, J1.B12, LED1.2, R1.2, R2.2, TP1.1, TP1.3, TP2.1, TP2.3
LED_A: LED1.1, R3.2
VBUS: F1.1, J1.A9, J1.B9
