brancz/urchin-plus-plus/hardware/layouts/left/left.kicad_pcb

## KiCad design hardware/layouts/left/left.kicad_pcb (2026-10-19)

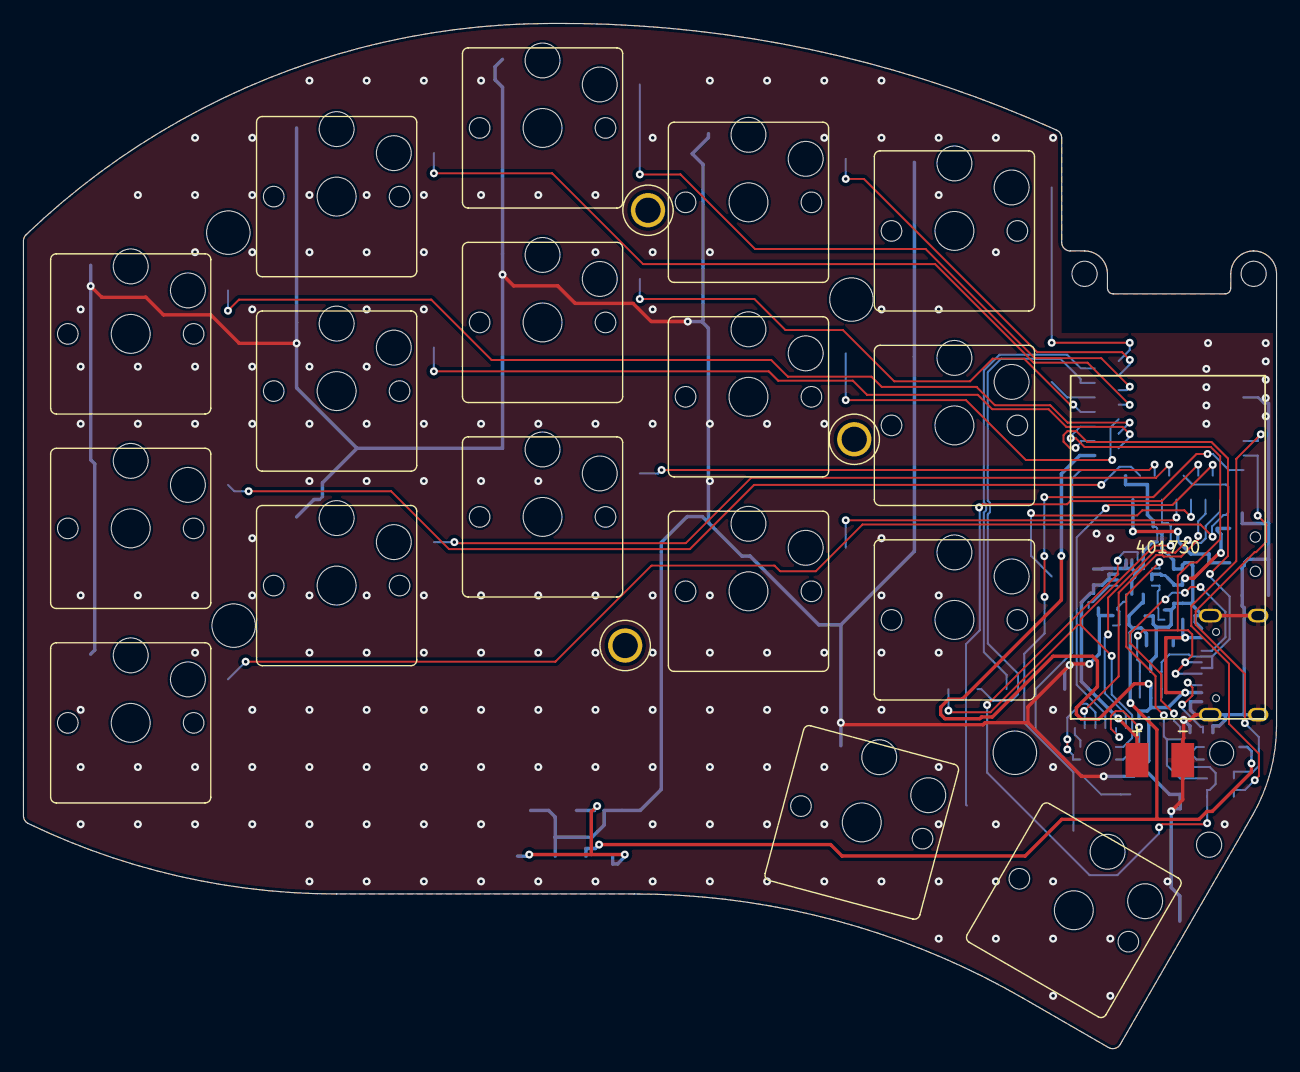
[picture p48: board left.kicad_pcb from above]

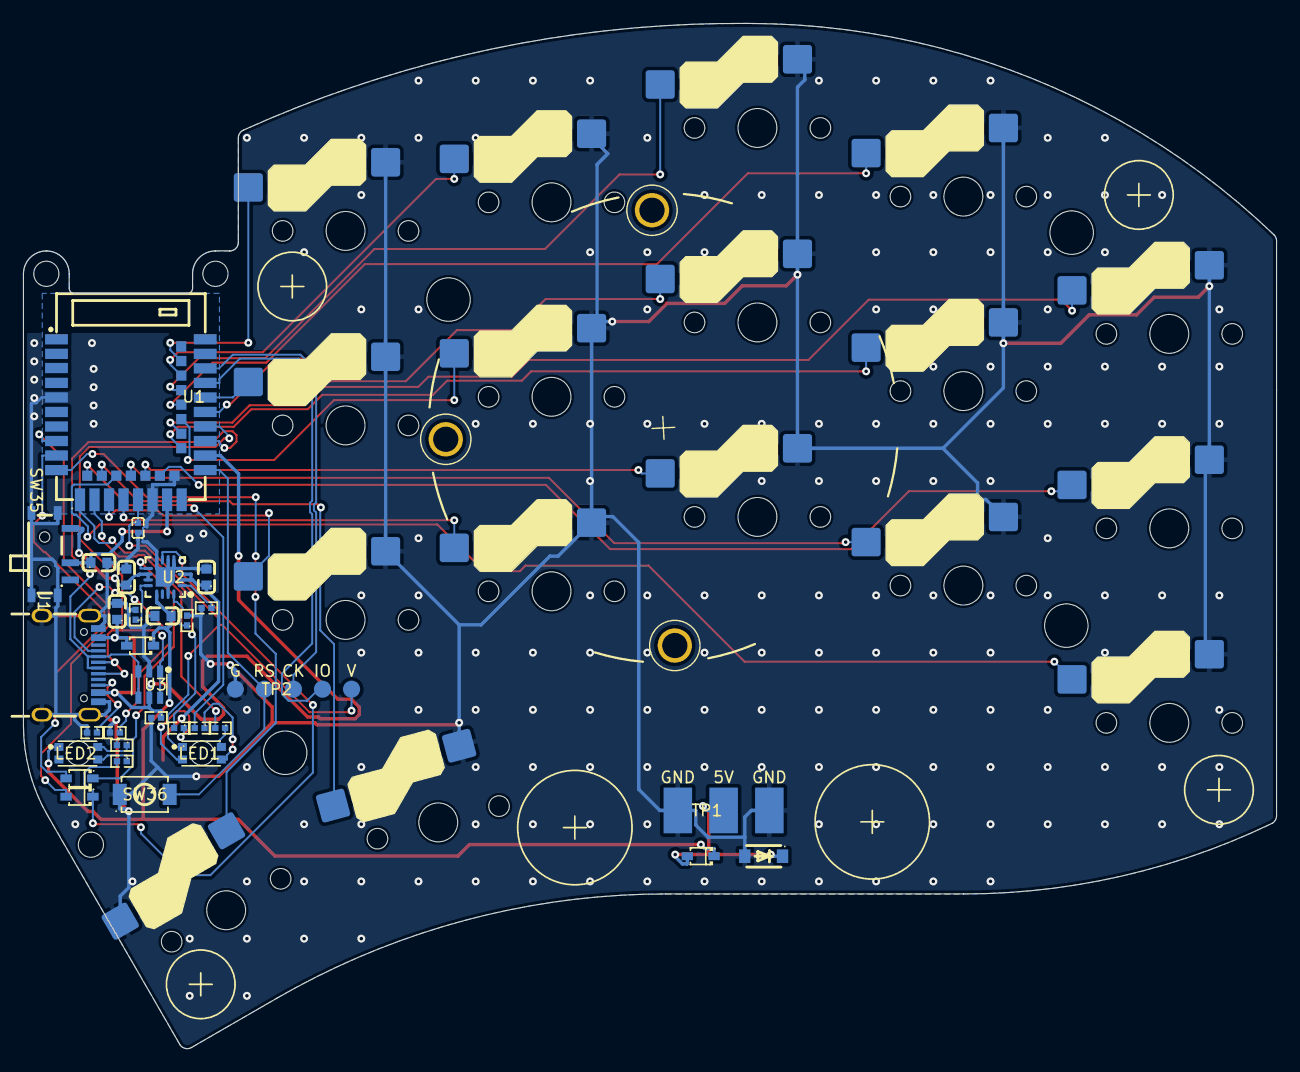
[picture p49: board left.kicad_pcb from below]

Board: 2 copper layers, 109.5 x 89.6 mm, 65 parts (38 on the bottom side), 47 nets.

Parts:
BT1: BAT_PADS
BT2: BATTERY_401730
C1: C0402
C2, C3, C4, C5, C6: C0603
D1, D2, D4, D5: SOD-323_L1.8-W1.3-LS2.5-RD
D3: SOD-123F_L2.8-W1.8-LS3.7-RD
H1: Tenting_Puck2_no_pads
H2, H3, H4, H5: M2_hole_4.2mm
H6, H7, H8: M2_hole_3.5mm
J1: USB-C_SMD-TYPE-C-31-M-12_1
LED1, LED2: LED-ARRAY-SMD_1206-4P-L3.2-W1.3-BR-EH
MK1, MK2: STEEL_DISC
MK3, MK4, MK5, MK6: RUBBER_FOOT
R1, R2, R3, R4, R5, R6, R7, R8, R9, R10, R11: R0402
SW1, SW2, SW3, SW4, SW5, SW6, SW7, SW8, SW9, SW10, SW11, SW12, SW13, SW14, SW15, SW16, SW17: SW_Hotswap_Kailh_Choc_V1_tweaked
SW35: SW-TH_MSK12C02
SW36: SW-SMD_L3.9-W3.0-P4.45
TP1: DOCK_PADS
TP2: SWD_PADS
U1: WIRELM-SMD_E73-2G4M08S1C
U2: QFN-16_L3.0-W3.0-P0.50-TL-EP1.7
U3: SOT-23-6_L2.9-W1.6-P0.95-LS2.8-BL

Connections:
CC1: J1.A5, R2.1
CC2: J1.B5, R3.1
CHG_N: D4.1, R6.2, U2.9
CHG_SENSE: D4.2, U1.9
DOCK_5V: D2.2, D3.1, TP1.2
GND: BT1.2, C1.2, C2.2, C3.2, C4.2, C5.2, C6.2, D3.2, J1.1, J1.2, J1.3, J1.4, J1.A1B12, J1.B1A12, R1.2, R2.2, R3.2, R4.2, R5.2, R11.2, SW1.1, SW2.1, SW3.1, SW4.1, SW5.1, SW6.1, SW7.1, SW8.1, SW9.1, SW10.1, SW11.1, SW12.1, SW13.1, SW14.1, SW15.1, SW16.1, SW17.2, SW35.4, SW36.2, TP1.1, TP1.3, TP2.5, U1.5, U1.21, U1.24, U2.4, U2.5, U2.6, U2.8, U2.15, U2.17, U3.2
ILIM: R4.1, U2.12
ISET: R5.1, U2.16
KEY_R0C0: SW1.2, U1.30
KEY_R0C1: SW2.2, U1.34
KEY_R0C2: SW3.2, U1.36
KEY_R0C3: SW4.2, U1.38
KEY_R0C4: SW5.2, U1.40
KEY_R1C0: SW6.2, U1.22
KEY_R1C1: SW7.2, U1.28
KEY_R1C2: SW8.2, U1.33
KEY_R1C3: SW9.2, U1.32
KEY_R1C4: SW10.2, U1.35
KEY_R2C0: SW11.2, U1.16
KEY_R2C1: SW12.2, U1.18
KEY_R2C2: SW13.2, U1.20
KEY_R2C3: SW14.2, U1.17
KEY_R2C4: SW15.2, U1.15
KEY_T0: SW16.2, U1.14
KEY_T1: SW17.1, U1.10
LED_B: R10.2, U1.11
LED_B_K: LED1.2, R10.1
LED_CHG_G: LED2.3, R7.1
LED_CHG_R: LED2.4, R6.1
LED_G: R9.2, U1.12
LED_G_K: LED1.3, R9.1
LED_R: R8.2, U1.13
LED_R_K: LED1.4, R8.1
PGOOD_N: D5.1, R7.2, U2.7
PGOOD_SENSE: D5.2, U1.8
RESET_N: SW36.1, TP2.4, U1.26
SWDCLK: TP2.3, U1.39
SWDIO: TP2.2, U1.37
TS: R1.1, U2.1
USB_DN: J1.A7, J1.B7, U1.29, U3.3, U3.4
USB_DP: J1.A6, J1.B6, U1.31, U3.1, U3.6
VBAT: BT1.1, C4.1, U2.2, U2.3
VBUS: C5.1, D1.2, J1.A4B9, J1.B4A9, R11.1, U1.27, U3.5
VDD: C1.1, LED1.1, TP2.1, U1.19
VDDH: C6.1, SW35.2, U1.23
VIN: C2.1, D1.1, D2.1, LED2.1, U2.13
VSYS: C3.1, SW35.1, U2.10, U2.11
