brancz/urchin-plus-plus/reports/phase0/kicad10-probe/kicad10-saved.kicad_pcb

## KiCad design reports/phase0/kicad10-probe/kicad10-saved.kicad_pcb (2026-10-18)

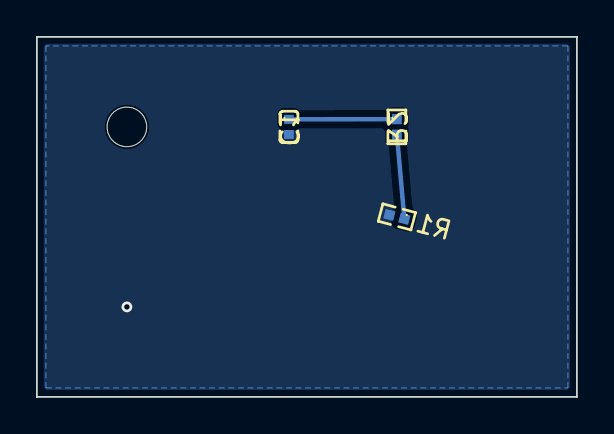
[picture p50: board kicad10-saved.kicad_pcb from below]

Board: 2 copper layers, 30.0 x 20.0 mm, 4 parts (3 on the bottom side), 3 nets.

Parts:
C1: C0402
H1: MountingHole_2.2mm_M2
R1, R2: R0402

Connections:
GND: C1.2, R1.2
MID: R1.1, R2.2
VCC: C1.1, R2.1
