brancz/urchin-plus-plus/(commit log)

2026-10-17 Phase 0: toolchain proof
    KiCad 10.0.7 fails the atopile round-trip: atopile 0.15.7 (and 0.15.9)
    can't parse any board KiCad 10 saves. Switch to KiCad 9.0.9 per the
    documented fallback; it passes the full round-trip.
    - scripts/roundtrip/run.sh: 11-step round-trip through scripts/ato_build.sh
    (edits survive rebuilds, net churn, uncommitted saves, renames, foreign
    footprints, Freerouting, KiKit), run locally and in CI
    - scripts/ato_build.sh: the only way to run ato build; guardrails, pre-build
    snapshot, stale-net repair, board diff in build mode
    - scripts/checks/: board_diff, board_history, kicad_guardrails, toolchain
    - scripts/parts/import_lcsc.py: LCSC parts as local atomic parts, sinc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
    [C0402_L1.0-W0.5-H0.5.step, R0402_L1.0-W0.5-H0.4.step, kicad10-saved.kicad_pcb, package-lock.json, package.json]
2026-10-17 fix_stale_nets: match copper by UUID to the pre-build board
    The first CI run showed atopile on Linux zeroing the net of copper on a
    re-created net, where on macOS it leaves the stale number; inferring from
    numbers missed the Linux case. Matching each segment, arc, via and zone by
    UUID to the snapshot covers both, plus renames.
2026-10-17 CI: skip reports/ in KiCad guardrails and board history
    reports/phase0/kicad10-probe/ keeps the KiCad 10-saved board as evidence;
    the guardrail correctly rejected it, but evidence isn't design.
2026-10-18 Phase 0: address second review
    - Bottom-side parts get bottom-side library footprints
    (scripts/parts/footprint_to_bottom.py, import_lcsc --side bottom default);
    atopile's flip on re-sync corrupted text rotations on every build. The
    guardrail refuses footprints on the other side from their library.
    - Guardrail mirrors atopile's data model (pcb.zig) and refuses content atopile
    would drop: locks, footprint zones, fp_curve, text boxes, groups.
    - ato_build.sh is all-or-nothing: restores the pre-build boards (with
    .kicad_pro/.kicad_dru) when ato build or a check fails.
    - fix_stale_nets keeps net numbers atopile kept (in-place renames); board_diff
    treats pad-consistent renames and swaps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
    [kicad10-saved.kicad_pcb]
2026-10-18 Phase 1: geometry extraction with zero-deviation check
    hardware/geometry/urchin.json from the original board; mechanical parts
    (key, puck, case holes) from the original footprints; scripts/checks/geometry.py
    compares any half's board against the original to the nanometre.
2026-10-18 Phase 1: address review (independent outline check, CI fetch of the original, NPTH case holes)
    geometry.py derives outline and closures from the original and compares
    full pad signatures; CI fetches duckyb/urchin at the recorded commit and
    checks that geometry file, parts and boards reproduce it. Case holes
    overlapping the puck or each other are dropped, the rest made non-plated;
    socket pads carry no paste. Phase 2 parts chosen (BQ24073 instead of
    BQ24075, see ARCHITECTURE.md), datasheets saved, part library imported.
    [C0402_L1.0-W0.5-H0.5.step, C0603_L1.6-W0.8-H0.8.step, LED-SMD-1206-4P_L3.2-W1.3-H1.1.step, QFN-16_L3.0-W3.0-P0.50-EP1.7.step, R0402_L1.0-W0.5-H0.4.step, SOD-123FL_L2.8-W1.8-H1.1-LS3.6.step, SOD-123F_L2.7-W1.6-LS3.8-RD.step, SOD-123_L2.7-W1.6-LS3.7-RD-1.step]
2026-10-18 Phase 2: datasheet pin names for the LCSC parts, pad-only parts (battery, dock, SWD)
    import_lcsc.py takes pin names from hardware/parts.json where EasyEDA's
    symbol is wrong or ambiguous (the RGB LED's three cathodes were all 'neg').
    custom_parts.py generates the battery, dock and SWD pads; KiCad's UUID
    generator is seeded so reruns are byte-identical.
2026-10-18 Phase 2: circuit for both halves, per-half GPIO maps, connectivity and BOM checks
    hardware/core.ato holds the shared electronics; scripts/circuit/gen_halves.py
    generates hardware/halves.ato and hardware/pinmap.json from geometry (keys and
    GPIO functions matched to module pads by shortest path around the module).
    scripts/checks/connectivity.py checks every pad against a netlist written from
    the datasheets; scripts/parts/bom_check.py checks live JLC stock. The puck
    footprint gets a silkscreen cross so atopile can place its designator.
    [left.kicad_pcb, right.kicad_pcb]
2026-10-18 Phase 3: placement of both halves, antenna keep-out, clearance and DRC checks
    hardware/placement.json places the left half's electronics (right half
    mirrored); scripts/placement/place.py writes positions, outline and the
    antenna keep-out rule area (--check in CI). scripts/checks/clearance.py
    checks part spacing, holes, edge, tenting puck, sides and the keep-out;
    scripts/checks/drc.py runs KiCad DRC with JLC rules (board_setup.py) and a
    short allow-list. Battery outline, steel discs and rubber feet are
    mechanical parts so courtyard checks cover them.
    Board-Diff-Allow: field-placement:*/Reference
    [left.kicad_pcb, right.kicad_pcb]
2026-10-18 Address phase 2 review: VBUS pull-down, Schottky sense diodes, LED and capacitor values, footprint pad angles
    - R11 10k holds VBUS low when docked (D1 reverse leakage); D4/D5 are B5819W;
    status LED green/blue 220R; charger OUT/BAT 10uF; dock TVS SMF6.0A.
    - footprint_to_bottom.py turns the flipped footprint back to 0 degrees so pad
    angles (and custom pad shapes) are right; all parts re-imported, geometry
    otherwise identical (checked in pcbnew).
    - ato_build.sh rebuilds until a --frozen build is clean; guardrails accept a
    swapped library part before a build.
    - connectivity.py checks LCSC numbers per designator and its own E73 GPIO table.
    - GPIO map avoids the module pins next to the ant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
    [R0402_L1.0-W0.5-H0.4.step, SOD-123FL_L2.8-W1.8-H1.1-LS3.6.step, SOD-123FL_L2.8-W1.8-LS3.7-RD-1.step, SOD-123F_L2.7-W1.6-LS3.8-RD.step, left.kicad_pcb, right.kicad_pcb]
2026-10-19 Phases 4-6: routed halves, validation, JLC bundle; address phase 3 and three phase 4-6 reviews
    Phase 3 review fixes: exact clearance checks, 3D model offsets,
    rot' = 180 - rot for the right half, unique UUIDs, per-half DRC
    allow-list, 1N5819WS diodes.
    Phase 4: both halves routed by scripts/routing/route.py (scripted USB-C
    joins, Freerouting with width/clearance variants checked with KiCad's
    connectivity, GND pours, solid module ground zone, stitching vias
    including under the module, widen.py to 0.15 mm). Rule areas: antenna
    keep-out, module core, no vias under J1's shell. Short post-routing
    repairs for the moved LED pads in hardware/routing_joins.json
    (scripts/routing/joins.py). 0 DRC error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
    [C0402_L1.0-W0.5-H0.5.step, SOD-123_L2.7-W1.6-LS3.7-RD-1.step, SOD-323_L1.8-W1.3-LS2.5-RD.step, bom.csv, left.kicad_pcb, positions.csv, right.kicad_pcb]
2026-10-19 Guardrail: refuse non-atopile footprints before a build again
    The pre-build mode skipped every footprint missing from the libraries so
    that a part swapped in the source passes until the build replaces it.
    That also let a foreign footprint through to atopile, which deletes it;
    board_diff caught the removal, but the phase 0 round-trip (step 9)
    expects the refusal before atopile runs. Footprints without an
    atopile_address are refused again.
    Claude-Session: https://claude.ai/code/session_01NUn1BpuArkM9wiRPYjsduC
    [kicad_guardrails.py]
2026-10-24 Phase 8: ZMK firmware for both halves and the UF2 bootloader
    - firmware/: a Zephyr module with the urchin_pp_left/urchin_pp_right board
    (ZMK main pinned, Zephyr 4.1 board format), the owner's keymap
    (brancz/urchin-zmk-firmware) with battery/connection indicators,
    zmk-rgbled-widget, and urchin,battery-power-aware, which keeps a docked
    or charging half from reporting the charger's 4.4 V output as a full
    battery (PGOOD/CHG read per sample; last on-battery level kept in
    GPREGRET2 across resets and deep-sleep wakes).
    - Key, LED and charger-status pins, the matrix transform and the ZMK
    Studio physical layout are generated from hardware/pinmap.json and the
    geometry file (scripts/fir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
    [battery_power_aware.c, gen_board.py]
2026-10-24 Firmware: report both halves' battery levels
    The left half fetches the right half's battery level, offers it to the
    host as a second Battery Service, and blinks both on its status LED
    (firmware/config/urchin_pp_left.conf, the left build only). macOS shows
    only the first Battery Service; the second is there for an app or script.
    The settings-reset images build without the user config.
    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
2026-10-24 Menu-bar app showing both halves' battery levels
    macOS shows only the first Battery Service, which is the left half's.
    urchin++ Battery (menubar/) reads both services that ZMK's battery proxy
    offers on the left half and shows "L 85% R 72%" in the menu bar.
    - It labels each Battery Level by its descriptors: Zephyr's "main"
    presentation format is the left half, and ZMK's "auxiliary" level
    named "Peripheral 0" is the right half. The right half's 0 shows as
    "no reading", because ZMK reports 0 for a peripheral that isn't
    connected.
    - It is a Swift package with an AppKit status item and CoreBluetooth.
    It is built with the Command Line Tools by scripts/menubar/build.sh
    (unit tests, th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
2026-10-24 Phase 7: printed cases and battery covers for both halves
    mech/ (was dock/) is a build123d project that builds each half's case
    and battery cover from the routed boards' own data, which is extracted
    into mech/data/*.json by scripts/mech/board_data.py. CI fails if that
    data is stale.
    scripts/mech/build.sh exports each half as STEP and builds the parts. It
    then checks them against the boards' 3D models plus modelled sockets,
    switches, keycaps and battery. Further checks cover the hardware stacks
    (thread engagement, screw tips), metal in the antenna keep-out, whether
    the board can drop into its case, and bed size. Locally it also renders
    the parts and slices them with Bambu Studio for the A1 m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
    [checks.py, cli.py, params.py, render.py]
2026-10-24 Phase 7: the charging dock, a dock PCB and a two-piece tray
    The dock PCB (dock-pcb/) is a long bar under both halves with three
    pogo pins at each end, and a tab in the middle carrying a power-only
    USB-C, a 0.5 A polyfuse, a TVS, the CC pull-downs and a power LED. It is
    assembled on its top, as its own small JLC order. The board follows the
    tray: `mech dock-geometry` writes its outline, magnet cutouts and the
    positions of the pins, USB-C and screws to dock-pcb/geometry.json.
    scripts/dock/ places it, checks its connectivity against a netlist
    written from the datasheets, and builds its JLC bundle (fab.sh, also a
    CI artifact). The 5 V trunk is a scripted pre-route.
    The tray (mech/src/mech/tray.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
    [F1206_L3.2-W1.7-H0.6.step, LED0805-RD.step, R0402_L1.0-W0.5-H0.4.step, SOD-123FL_L2.8-W1.8-LS3.7-RD-1.step, TESTPOINT-SMD_BD2.0_YTC1P-4020-01.step, TYPE-C-SMD_6P-L8.9-W6.8-H3.2-P1.00.step, bom.csv, dock.kicad_pcb]
2026-10-24 Phase 7 done: link the green CI run with the dock bundle
    CI run 40118268118 passed every job on 87f28d6 and attached the dock
    PCB's JLC bundle and the printed parts. The dock PCB is ready for the
    owner to order, with the upload checklist in reports/phase7/README.md.
    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
2026-10-24 Phase 7: hardware bought in Germany, with its review fixed
    The standoffs, steel discs and cells in the phase 7 design weren't all
    sold in Germany. The battery cover now has printed posts held by M2 x 16
    nylon screws and nylon nuts, the dock's magnets pull on M5 washers in a
    1.2 mm recess, and the checks model the longest 401730 cell sold
    (32.5 x 17.5 x 4.5 mm). No keyboard PCB change.
    The reviewer's findings on that change (review.md, "Hardware change"):
    - Posts 4.0 mm on a 2.3 mm bore with a lead-in; fit rows grow each post
    by the cover's play (0.261 mm to the keycaps) and model each nut as a
    hexagon, flat toward its keycap, grown by its screw's play.
    - The cell is modelled from BT2's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
    [checks.py, cli.py, params.py, tray.py]
2026-10-25 JLC checklist: the design count gets its own line
    JLC held the gate 3 order for a $14.60 supplement: the order said one
    design, and the panel holds two (left and right half). The checklist
    asked for "Different Design: 2" inside the delivery-format line, where
    it was missed. It is now its own line, the panel's Gerber zip is named
    urchin-panel-2designs-gerbers.zip so the reminder is in front of the
    uploader, and the dock's checklist names its value (1).
    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
2026-10-25 mech: a 3D preview of the finished keyboard and dock
    `mech preview` writes one HTML page (three.js r128 from a CDN, meshes
    inlined: 16-bit quantized, gzipped, about 2.5 MB) showing both halves
    on the desk, in the dock or exploded, with an X-ray mode and a choice
    of finishes (black prints and keycaps by default, the owner's pick).
    The cases, covers, tray and boards are the built parts and STEP
    exports, the hardware sits where the checks put it, and the Choc
    switches and keycaps are simplified. scripts/mech/build.sh runs it
    (PREVIEW=0 skips), and CI ships it in the printed-parts artifact.
    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
    [cli.py, preview.py]
2026-10-25 mech: a top shell over each half
    The battery cover gave way to a printed top shell, at the owner's
    request for a more finished look. The shell is the switch plate (Kailh's
    Choc v1 drawing: flange 2.2 mm above the PCB, 1.2 mm plate), wraps the
    edges down to a chamfered seam with the case, and takes the battery under
    a flat lid with windows over the LEDs. Keys stand proud: the rim ends
    about 1 mm below the keycaps.
    Two steel M2 x 8 per half go in from the case's underside and cut their
    thread in the shell; printed pins on the case locate it at the two holes
    in the antenna keep-out. No hardware shows from the top. The nylon
    screws and nuts, and the case's insert, are no longer needed.
    The new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
    [checks.py, cli.py, dock_checks.py, params.py, preview.py, render.py]
2026-10-25 dock: flat, pins on the halves, USB-C at the back; review fixed
    The owner found a half hard to lift out of the deep pockets, and wants
    the cable to leave at the back so the dock can sit at the far edge of a
    desk. The dock PCB wasn't ordered yet, so the dock was redesigned:
    - Three pogo pins (C5221284) per half, hand-soldered on the existing TP1
    pads with a printed jig, plungers down through the case's window.
    - The tray is a 6.6 mm slab with 2.6 mm pockets; a docked half stands
    proud and is picked up by its sides.
    - The dock PCB is a flat U with six ENIG contacts (3.2 x 6.0 mm), located
    by the magnet bosses and held by a glued printed cover. No screws or
    inserts.
    - A mid-mount USB-C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
    [TESTPOINT-SMD_BD2.0_YTC1P-4020-01.step, TYPE-C-SMD_6P-L8.9-W6.8-H3.2-P1.00.step, TYPE-C-SMD_TYPE-C-31-M-28A.step, bom.csv, dock.kicad_pcb, positions.csv]
2026-10-25 dock: floor plates hide the dock PCB; review fixed
    The owner looks at the empty dock most of the time and didn't want to
    see a circuit board in it. A 0.4 mm printed plate now covers each
    pocket's floor and the dock PCB under it; only the three gold contacts
    show, through a slot. Neither PCB changes.
    - dock_floor_{left,right}: the pocket's outline less 0.15 mm, one slot
    0.4 mm past each half's contacts (separate windows would leave a tip
    too little room), the tray's holes under the feet and the puck.
    Ironed, glued down.
    - The contacts now lie 0.4 mm under the case, so the case floor is
    1.2 mm (was 1.6) and the compression stays 0.85 mm. A pad inside each
    case covers the steel washe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
    [checks.py, cli.py, dock_checks.py, params.py, preview.py, tray.py]
2026-10-25 Phase 7: link the green CI run of the floor plates
    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
2026-10-26 Phase 7: commit the 3D preview with the evidence
    reports/phase7/preview.html is the preview from the floor-plate build
    (commit 314da27), next to the renders. It's a copy of the build output,
    like the renders; each CI run's own build stays in its printed-parts
    artifact.
    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
2026-10-30 Keyboard order: LED1/LED2 soldered as-is after JLC's query
    JLC asked about LED1 and LED2 on both halves: the pads overlap the
    LED's end terminals by 0.30 mm, moved out from the datasheet's 0.45 to
    keep JLC's clearance to the light hole. The owner chose to solder them
    as they are, without JLC's guarantee on those joints. Recorded in the
    decision log and the open items, with a loupe check and a reflow step
    at bring-up. No PCB change.
    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
2026-10-30 Keyboard order: JLC's placement checked part by part
    The owner confirmed JLC's placement preview before it was checked in
    detail. Their screenshots of the preview were then compared with each
    footprint's pad 1 and pad nets in bottom view. U1, U2, U3, D1-D5, LED1,
    LED2, J1 and SW35 match on both halves, and JLC lists all 60 placements
    as assembled. The crops and the comparison table are in
    reports/phase6/jlc-placement/.
    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
2026-10-30 License: MIT, as the original Urchin
    LICENSE keeps duckyb's 2022 copyright notice next to the owner's, since
    the board outline, key positions and tenting-puck mount come from the
    Urchin. NOTICE lists what the MIT license doesn't cover: the datasheets,
    the LCSC/EasyEDA footprints and 3D models, and the vendored EasyEDA skill.
    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
